phelanp/TSI-2018/Circuit_layout/TSI_BOM.xlsx

Reference | Value | DigiKey P/N | URL | Man P/N | Description | Price
U13 | PDQ10-D | 102-3865-ND | http://www.digikey.com/product-detail/en/cui-inc/PDQ10-Q24-S5-D/102-3865-ND/6165206 | PDQ10-Q24-S5-D | DC/DC CONVERTER 5V 10W | 25.82
U1 | PDM2-S24-S12 | 102-2728-ND | https://www.digikey.com/product-detail/en/cui-inc/PDM2-S24-S12-S/102-2728-ND/4009652 | PDM2-S24-S12-S | CONVERT DC/DC 2W 12V 167MA OUT | 5.71
SW1 | SW_PUSH | 1715-1676-1-ND | http://www.digikey.com/products/en?keywords=ckn9363ct-nd | 1.14100.5030000 | SWITCH PUSH SPST-NO 0.1A 42V | 2.4
SW2 | TS5A3159-Q1 | 296-39512-1-ND | http://www.digikey.com/product-detail/en/texas-instruments/TS5A3159QDBVRQ1/296-39512-1-ND/5143458 | TS5A3159QDBVRQ1 | IC ANLG SW SPDT SOT23-6 | 0.98
U4 | LM95071-Q1 | 296-40259-1-ND | https://www.digikey.com/products/en/sensors-transducers/temperature-sensors-analog-and-digital-output/518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 | LM95071QIMFX/NOPB | SENSOR TEMPERATURE SPI SOT23-5 | 2.9
U8 | 74ACT11030 | 296-4180-1-ND | http://www.digikey.com/product-detail/en/texas-instruments/74ACT11030DR/296-4180-1-ND/375133 | 74ACT11030DR | IC GATE NAND 1CH 8-INP 14-SOIC | 2.28
R44 | 120 | 311-120CRCT-ND | http://www.digikey.com/product-detail/en/yageo/RC0805FR-07120RL/311-120CRCT-ND/730522 | RC0805FR-07120RL | RES SMD 120 OHM 1% 1/8W 0805 | 0.1
R12 | 150 | 311-150CRCT-ND | http://www.digikey.com/product-detail/en/yageo/RC0805FR-07150RL/311-150CRCT-ND/730560 | RC0805FR-07150RL | RES SMD 150 OHM 1% 1/8W 0805 | 0.1
R15 | 150 | 311-150CRCT-ND | http://www.digikey.com/product-detail/en/yageo/RC0805FR-07150RL/311-150CRCT-ND/730560 | RC0805FR-07150RL | RES SMD 150 OHM 1% 1/8W 0805 | 0.1
R27 | 150 | 311-150CRCT-ND | http://www.digikey.com/product-detail/en/yageo/RC0805FR-07150RL/311-150CRCT-ND/730560 | RC0805FR-07150RL | RES SMD 150 OHM 1% 1/8W 0805 | 0.1
R70 | 47k | 311-47.0KCRCT-ND | http://www.digikey.com/product-detail/en/yageo/RC0805FR-0747KL/311-47.0KCRCT-ND/730920 | RC0805FR-0747KL | RES SMD 47K OHM 1% 1/8W 0805 | 0.1
C5 | 10p | 399-1108-1-ND | http://www.digikey.com/product-detail/en/kemet/C0805C100J5GACTU/399-1108-1-ND/411383 | C0805C100J5GACTU | CAP CER 10PF 50V NP0 0805 | 0.1
C6 | 10p | 399-1108-1-ND | http://www.digikey.com/product-detail/en/kemet/C0805C100J5GACTU/399-1108-1-ND/411383 | C0805C100J5GACTU | CAP CER 10PF 50V NP0 0805 | 0.1
C28 | 100p | 399-1122-1-ND | http://www.digikey.com/product-detail/en/kemet/C0805C101J5GACTU/399-1122-1-ND/411397 | C0805C101J5GACTU | CAP CER 100PF 50V NP0 0805 | 0.1
C29 | 100p | 399-1122-1-ND | http://www.digikey.com/product-detail/en/kemet/C0805C101J5GACTU/399-1122-1-ND/411397 | C0805C101J5GACTU | CAP CER 100PF 50V NP0 0805 | 0.1
C30 | 100p | 399-1122-1-ND | http://www.digikey.com/product-detail/en/kemet/C0805C101J5GACTU/399-1122-1-ND/411397 | C0805C101J5GACTU | CAP CER 100PF 50V NP0 0805 | 0.1
C41 | 100p | 399-1122-1-ND | http://www.digikey.com/product-detail/en/kemet/C0805C101J5GACTU/399-1122-1-ND/411397 | C0805C101J5GACTU | CAP CER 100PF 50V NP0 0805 | 0.1
C46 | 100p | 399-1122-1-ND | http://www.digikey.com/product-detail/en/kemet/C0805C101J5GACTU/399-1122-1-ND/411397 | C0805C101J5GACTU | CAP CER 100PF 50V NP0 0805 | 0.1
C47 | 100p | 399-1122-1-ND | http://www.digikey.com/product-detail/en/kemet/C0805C101J5GACTU/399-1122-1-ND/411397 | C0805C101J5GACTU | CAP CER 100PF 50V NP0 0805 | 0.1
C1 | 0.1u | 399-1168-1-ND | http://www.digikey.com/product-detail/en/kemet/C0805C104K3RACTU/399-1168-1-ND/411443 | C0805C104K3RACTU | CAP CER 0.1UF 25V X7R 0805 | 0.1
C12 | 0.1u | 399-1168-1-ND | http://www.digikey.com/product-detail/en/kemet/C0805C104K3RACTU/399-1168-1-ND/411443 | C0805C104K3RACTU | CAP CER 0.1UF 25V X7R 0805 | 0.1
C14 | 0.1u | 399-1168-1-ND | http://www.digikey.com/product-detail/en/kemet/C0805C104K3RACTU/399-1168-1-ND/411443 | C0805C104K3RACTU | CAP CER 0.1UF 25V X7R 0805 | 0.1
C15 | 0.1u | 399-1168-1-ND | http://www.digikey.com/product-detail/en/kemet/C0805C104K3RACTU/399-1168-1-ND/411443 | C0805C104K3RACTU | CAP CER 0.1UF 25V X7R 0805 | 0.1
C16 | 0.1u | 399-1168-1-ND | http://www.digikey.com/product-detail/en/kemet/C0805C104K3RACTU/399-1168-1-ND/411443 | C0805C104K3RACTU | CAP CER 0.1UF 25V X7R 0805 | 0.1
C17 | 0.1u | 399-1168-1-ND | http://www.digikey.com/product-detail/en/kemet/C0805C104K3RACTU/399-1168-1-ND/411443 | C0805C104K3RACTU | CAP CER 0.1UF 25V X7R 0805 | 0.1
C18 | 0.1u | 399-1168-1-ND | http://www.digikey.com/product-detail/en/kemet/C0805C104K3RACTU/399-1168-1-ND/411443 | C0805C104K3RACTU | CAP CER 0.1UF 25V X7R 0805 | 0.1
C2 | 0.1u | 399-1168-1-ND | http://www.digikey.com/product-detail/en/kemet/C0805C104K3RACTU/399-1168-1-ND/411443 | C0805C104K3RACTU | CAP CER 0.1UF 25V X7R 0805 | 0.1
C22 | 0.1u | 399-1168-1-ND | http://www.digikey.com/product-detail/en/kemet/C0805C104K3RACTU/399-1168-1-ND/411443 | C0805C104K3RACTU | CAP CER 0.1UF 25V X7R 0805 | 0.1
C23 | 0.1u | 399-1168-1-ND | http://www.digikey.com/product-detail/en/kemet/C0805C104K3RACTU/399-1168-1-ND/411443 | C0805C104K3RACTU | CAP CER 0.1UF 25V X7R 0805 | 0.1
C25 | 0.1u | 399-1168-1-ND | http://www.digikey.com/product-detail/en/kemet/C0805C104K3RACTU/399-1168-1-ND/411443 | C0805C104K3RACTU | CAP CER 0.1UF 25V X7R 0805 | 0.1
C26 | 0.1u | 399-1168-1-ND | http://www.digikey.com/product-detail/en/kemet/C0805C104K3RACTU/399-1168-1-ND/411443 | C0805C104K3RACTU | CAP CER 0.1UF 25V X7R 0805 | 0.1
C31 | 0.1u | 399-1168-1-ND | http://www.digikey.com/product-detail/en/kemet/C0805C104K3RACTU/399-1168-1-ND/411443 | C0805C104K3RACTU | CAP CER 0.1UF 25V X7R 0805 | 0.1
C32 | 0.1u | 399-1168-1-ND | http://www.digikey.com/product-detail/en/kemet/C0805C104K3RACTU/399-1168-1-ND/411443 | C0805C104K3RACTU | CAP CER 0.1UF 25V X7R 0805 | 0.1
C33 | 0.1u | 399-1168-1-ND | http://www.digikey.com/product-detail/en/kemet/C0805C104K3RACTU/399-1168-1-ND/411443 | C0805C104K3RACTU | CAP CER 0.1UF 25V X7R 0805 | 0.1
C34 | 0.1u | 399-1168-1-ND | http://www.digikey.com/product-detail/en/kemet/C0805C104K3RACTU/399-1168-1-ND/411443 | C0805C104K3RACTU | CAP CER 0.1UF 25V X7R 0805 | 0.1
C35 | 0.1u | 399-1168-1-ND | http://www.digikey.com/product-detail/en/kemet/C0805C104K3RACTU/399-1168-1-ND/411443 | C0805C104K3RACTU | CAP CER 0.1UF 25V X7R 0805 | 0.1
C37 | 0.1u | 399-1168-1-ND | http://www.digikey.com/product-detail/en/kemet/C0805C104K3RACTU/399-1168-1-ND/411443 | C0805C104K3RACTU | CAP CER 0.1UF 25V X7R 0805 | 0.1
C38 | 0.1u | 399-1168-1-ND | http://www.digikey.com/product-detail/en/kemet/C0805C104K3RACTU/399-1168-1-ND/411443 | C0805C104K3RACTU | CAP CER 0.1UF 25V X7R 0805 | 0.1
C40 | 0.1u | 399-1168-1-ND | http://www.digikey.com/product-detail/en/kemet/C0805C104K3RACTU/399-1168-1-ND/411443 | C0805C104K3RACTU | CAP CER 0.1UF 25V X7R 0805 | 0.1
C42 | 0.1u | 399-1168-1-ND | http://www.digikey.com/product-detail/en/kemet/C0805C104K3RACTU/399-1168-1-ND/411443 | C0805C104K3RACTU | CAP CER 0.1UF 25V X7R 0805 | 0.1
C43 | 0.1u | 399-1168-1-ND | http://www.digikey.com/product-detail/en/kemet/C0805C104K3RACTU/399-1168-1-ND/411443 | C0805C104K3RACTU | CAP CER 0.1UF 25V X7R 0805 | 0.1
C44 | 0.1u | 399-1168-1-ND | http://www.digikey.com/product-detail/en/kemet/C0805C104K3RACTU/399-1168-1-ND/411443 | C0805C104K3RACTU | CAP CER 0.1UF 25V X7R 0805 | 0.1
C45 | 0.1u | 399-1168-1-ND | http://www.digikey.com/product-detail/en/kemet/C0805C104K3RACTU/399-1168-1-ND/411443 | C0805C104K3RACTU | CAP CER 0.1UF 25V X7R 0805 | 0.1
C7 | 0.1u | 399-1168-1-ND | http://www.digikey.com/product-detail/en/kemet/C0805C104K3RACTU/399-1168-1-ND/411443 | C0805C104K3RACTU | CAP CER 0.1UF 25V X7R 0805 | 0.1
C8 | 0.1u | 399-1168-1-ND | http://www.digikey.com/product-detail/en/kemet/C0805C104K3RACTU/399-1168-1-ND/411443 | C0805C104K3RACTU | CAP CER 0.1UF 25V X7R 0805 | 0.1
SW3 | JS202011CQN | 401-2001-ND | http://www.digikey.com/product-detail/en/c-k/JS202011CQN/401-2001-ND/1640097 | JS202011CQN | SWITCH SLIDE DPDT 300MA 6V | 0.41
D3 | Spare/Fault | 475-1278-1-ND | http://www.digikey.com/product-detail/en/osram-opto-semiconductors-inc/LS-R976-NR-1/475-1278-1-ND/1642798 | LS R976-NR-1 | LED RED DIFFUSED 0805 SMD | 0.26
D1 | Power | 475-1410-1-ND | http://www.digikey.com/product-detail/en/osram-opto-semiconductors-inc/LG-R971-KN-1/475-1410-1-ND/1802598 | LG R971-KN-1 | LED GREEN DIFFUSED 0805 SMD | 0.25
D2 | Heartbeat | 475-2560-1-ND | http://www.digikey.com/product-detail/en/osram-opto-semiconductors-inc/LY-R976-PS-36/475-2560-1-ND/1802687 | LY R976-PS-36 | LED YELLOW DIFFUSED 0805 SMD | 0.35
C10 | 10uF | 490-10515-1-ND | http://www.digikey.com/product-detail/en/murata-electronics-north-america/GRM21BR6YA106ME43L/490-10515-1-ND/5026446 | GRM21BR6YA106ME43L | CAP CER 10UF 35V X5R 0805 | 0.36
C11 | 10uF | 490-10515-1-ND | http://www.digikey.com/product-detail/en/murata-electronics-north-america/GRM21BR6YA106ME43L/490-10515-1-ND/5026446 | GRM21BR6YA106ME43L | CAP CER 10UF 35V X5R 0805 | 0.36
C19 | 10uF | 490-10515-1-ND | http://www.digikey.com/product-detail/en/murata-electronics-north-america/GRM21BR6YA106ME43L/490-10515-1-ND/5026446 | GRM21BR6YA106ME43L | CAP CER 10UF 35V X5R 0805 | 0.36
C24 | 1uF | 490-3550-1-ND | http://www.digikey.com/product-detail/en/murata-electronics-north-america/GRM55DR72E105KW01L/490-3550-1-ND/789455 | GRM55DR72E105KW01L | CAP CER 1UF 250V X7R 2220 | 0.85
C4 | 47u | 490-6538-1-ND | http://www.digikey.com/product-detail/en/murata-electronics-north-america/GRM32ER61C476KE15K/490-6538-1-ND/3845735 | GRM32ER61C476KE15K | CAP CER 47UF 16V X5R 1210 | 0.86
U18 | TS912 | 497-10252-1-ND | http://www.digikey.com/product-detail/en/stmicroelectronics/TS912IYDT/497-10252-1-ND/2193329 | TS912IYDT | IC OPAMP GP 1.4MHZ RRO 8SO | 1.54
U6 | TS912 | 497-10252-1-ND | http://www.digikey.com/product-detail/en/stmicroelectronics/TS912IYDT/497-10252-1-ND/2193329 | TS912IYDT | IC OPAMP GP 1.4MHZ RRO 8SO | 1.54
U22 | TS372 | 497-2271-1-ND | http://www.digikey.com/product-detail/en/stmicroelectronics/TS372IDT/497-2271-1-ND/599224 | TS372IDT | IC COMP LP DUAL CMOS VOLT 8 SOIC | 0.62
D4 | Spare | 516-1445-1-ND | http://www.digikey.com/product-detail/en/broadcom-limited/HSMR-C170/516-1445-1-ND/637769 | HSMR-C170 | LED BLUE DIFFUSED 0805 SMD | 0.89
U19 | ACPL-C870 | 516-2578-5-ND | http://www.digikey.com/product-detail/en/broadcom-limited/ACPL-C870-000E/516-2578-5-ND/3523705 | ACPL-C870-000E | IC OPAMP ISOLATION 100KHZ 8SO | 5.39
U20 | ACPL-C870 | 516-2578-5-ND | http://www.digikey.com/product-detail/en/broadcom-limited/ACPL-C870-000E/516-2578-5-ND/3523705 | ACPL-C870-000E | IC OPAMP ISOLATION 100KHZ 8SO | 5.39
C3 | 2.2uF | 587-1293-1-ND | http://www.digikey.com/product-detail/en/taiyo-yuden/EMK212BJ225KG-T/587-1293-1-ND/931070 | EMK212BJ225KG-T | CAP CER 2.2UF 16V X5R 0805 | 0.16
L1 | 100uH | 587-2004-1-ND | https://www.digikey.com/product-detail/en/taiyo-yuden/NR8040T101M/587-2004-1-ND/1739117 | NR8040T101M | FIXED IND 100UH 1A 377 MOHM SMD | 0.6
CON1 | AVR-JTAG-10 | 609-4054-ND | http://www.digikey.com/product-detail/en/20021521-00010T1LF/609-4054-ND/2414951 | 20021521-00010T1LF | CONN HEADER 10POS DUAL SHRD SMD | 1.11
Y1 | 10MHz | 887-1741-1-ND | https://www.digikey.com/products/en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 | 7A-10.000MAAE-T | CRYSTAL 10.0000MHZ 12PF SMD | 0.66
P1 | TSV | A113980-ND | https://www.digikey.com/product-detail/en/te-connectivity-amp-connectors/556881-2/A113980-ND/294120 | 556881-2 | CONN RCPT 2POS 11.18MM PCB SLDR | 7.13
U7 | AT90CAN128-A | AT90CAN128-16AURCT-ND | https://www.digikey.com/product-detail/en/microchip-technology/AT90CAN128-16AUR/AT90CAN128-16AURCT-ND/3789383 | AT90CAN128-16AUR | IC MCU 8BIT 128KB FLASH 64TQFP | 7.66
U5 | LM7810CT | LM7810CT-ND | http://www.digikey.com/products/en?keywords=lm7810ct | LM7810CT | IC REG LDO 10V 1A TO220-3 | 0.64 | Changed to LM7810ACT
U16 | LTC3638 | LTC3638EMSE#PBF-ND | http://www.digikey.com/product-detail/en/linear-technology/LTC3638EMSE-PBF/LTC3638EMSE-PBF-ND/4693775 | LTC3638EMSE#PBF | IC REG BUCK ADJ 0.25A 16MSOP | 7.79
U10 | MCP2551-I/SN | MCP2551-I/SN-ND | http://www.digikey.com/product-detail/en/microchip-technology/MCP2551-I-SN/MCP2551-I-SN-ND/509452 | MCP2551-I/SN | IC TRANSCEIVER CAN HI-SPD 8-SOIC | 1.05
U21 | MCP6001 | MCP6001T-I/OTCT-ND | http://www.digikey.com/product-detail/en/microchip-technology/MCP6001T-I-OT/MCP6001T-I-OTCT-ND/697158 | MCP6001T-I/OT | IC OPAMP GP 1MHZ RRO SOT23-5 | 0.25
U2 | MCP6002 | MCP6002T-I/SNCT-ND | http://www.digikey.com/product-detail/en/microchip-technology/MCP6002T-I-SN/MCP6002T-I-SNCT-ND/4307905 | MCP6002T-I/SN | IC OPAMP GP 1MHZ RRO 8SOIC | 0.34
U17 | MCP6004 | MCP6004T-I/SLCT-ND | http://www.digikey.com/product-detail/en/microchip-technology/MCP6004T-I-SL/MCP6004T-I-SLCT-ND/5013527 | MCP6004T-I/SL | IC OPAMP GP RRO 1MHZ 14-SOIC | 0.45
U3 | MCP6004 | MCP6004T-I/SLCT-ND | http://www.digikey.com/product-detail/en/microchip-technology/MCP6004T-I-SL/MCP6004T-I-SLCT-ND/5013527 | MCP6004T-I/SL | IC OPAMP GP RRO 1MHZ 14-SOIC | 0.45
Q2 | MMBF170 | MMBF170CT-ND | http://www.digikey.com/product-detail/en/fairchild-on-semiconductor/MMBF170/MMBF170CT-ND/244295 | MMBF170 | MOSFET N-CH 60V 500MA SOT-23 | 0.35
Q3 | MMBF170 | MMBF170CT-ND | http://www.digikey.com/product-detail/en/fairchild-on-semiconductor/MMBF170/MMBF170CT-ND/244295 | MMBF170 | MOSFET N-CH 60V 500MA SOT-23 | 0.35
R37 | 1k | P1.00KCCT-ND | http://www.digikey.com/product-detail/en/panasonic-electronic-components/ERJ-6ENF1001V/P1.00KCCT-ND/118957 | ERJ-6ENF1001V | RES SMD 1K OHM 1% 1/8W 0805 | 0.1
R11 | 10k | P10.0KCCT-ND | http://www.digikey.com/product-detail/en/panasonic-electronic-components/ERJ-6ENF1002V/P10.0KCCT-ND/119248 | ERJ-6ENF1002V | RES SMD 10K OHM 1% 1/8W 0805 | 0.1
R13 | 10k | P10.0KCCT-ND | http://www.digikey.com/product-detail/en/panasonic-electronic-components/ERJ-6ENF1002V/P10.0KCCT-ND/119248 | ERJ-6ENF1002V | RES SMD 10K OHM 1% 1/8W 0805 | 0.1
R14 | 10k | P10.0KCCT-ND | http://www.digikey.com/product-detail/en/panasonic-electronic-components/ERJ-6ENF1002V/P10.0KCCT-ND/119248 | ERJ-6ENF1002V | RES SMD 10K OHM 1% 1/8W 0805 | 0.1
R17 | 10k | P10.0KCCT-ND | http://www.digikey.com/product-detail/en/panasonic-electronic-components/ERJ-6ENF1002V/P10.0KCCT-ND/119248 | ERJ-6ENF1002V | RES SMD 10K OHM 1% 1/8W 0805 | 0.1
R18 | 10k | P10.0KCCT-ND | http://www.digikey.com/product-detail/en/panasonic-electronic-components/ERJ-6ENF1002V/P10.0KCCT-ND/119248 | ERJ-6ENF1002V | RES SMD 10K OHM 1% 1/8W 0805 | 0.1
R21 | 10k | P10.0KCCT-ND | http://www.digikey.com/product-detail/en/panasonic-electronic-components/ERJ-6ENF1002V/P10.0KCCT-ND/119248 | ERJ-6ENF1002V | RES SMD 10K OHM 1% 1/8W 0805 | 0.1
R22 | 10k | P10.0KCCT-ND | http://www.digikey.com/product-detail/en/panasonic-electronic-components/ERJ-6ENF1002V/P10.0KCCT-ND/119248 | ERJ-6ENF1002V | RES SMD 10K OHM 1% 1/8W 0805 | 0.1
R23 | 10k | P10.0KCCT-ND | http://www.digikey.com/product-detail/en/panasonic-electronic-components/ERJ-6ENF1002V/P10.0KCCT-ND/119248 | ERJ-6ENF1002V | RES SMD 10K OHM 1% 1/8W 0805 | 0.1
R28 | 10k | P10.0KCCT-ND | http://www.digikey.com/product-detail/en/panasonic-electronic-components/ERJ-6ENF1002V/P10.0KCCT-ND/119248 | ERJ-6ENF1002V | RES SMD 10K OHM 1% 1/8W 0805 | 0.1
R29 | 10k | P10.0KCCT-ND | http://www.digikey.com/product-detail/en/panasonic-electronic-components/ERJ-6ENF1002V/P10.0KCCT-ND/119248 | ERJ-6ENF1002V | RES SMD 10K OHM 1% 1/8W 0805 | 0.1
R3 | 10k | P10.0KCCT-ND | http://www.digikey.com/product-detail/en/panasonic-electronic-components/ERJ-6ENF1002V/P10.0KCCT-ND/119248 | ERJ-6ENF1002V | RES SMD 10K OHM 1% 1/8W 0805 | 0.1
R31 | 10k | P10.0KCCT-ND | http://www.digikey.com/product-detail/en/panasonic-electronic-components/ERJ-6ENF1002V/P10.0KCCT-ND/119248 | ERJ-6ENF1002V | RES SMD 10K OHM 1% 1/8W 0805 | 0.1
R39 | 10k | P10.0KCCT-ND | http://www.digikey.com/product-detail/en/panasonic-electronic-components/ERJ-6ENF1002V/P10.0KCCT-ND/119248 | ERJ-6ENF1002V | RES SMD 10K OHM 1% 1/8W 0805 | 0.1
R4 | 10k | P10.0KCCT-ND | http://www.digikey.com/product-detail/en/panasonic-electronic-components/ERJ-6ENF1002V/P10.0KCCT-ND/119248 | ERJ-6ENF1002V | RES SMD 10K OHM 1% 1/8W 0805 | 0.1
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
R51 | 250k | P249KCCT-ND | http://www.digikey.com/product-detail/en/panasonic-electronic-components/ERJ-6ENF2493V/P249KCCT-ND/119664 | ERJ-6ENF2493V | RES SMD 249K OHM 1% 1/8W 0805 | 0.1
R52 | 250k | P249KCCT-ND | http://www.digikey.com/product-detail/en/panasonic-electronic-components/ERJ-6ENF2493V/P249KCCT-ND/119664 | ERJ-6ENF2493V | RES SMD 249K OHM 1% 1/8W 0805 | 0.1
R69 | 250k | P249KCCT-ND | http://www.digikey.com/product-detail/en/panasonic-electronic-components/ERJ-6ENF2493V/P249KCCT-ND/119664 | ERJ-6ENF2493V | RES SMD 249K OHM 1% 1/8W 0805 | 0.1
R71 | 330 | P330CCT-ND | http://www.digikey.com/product-detail/en/panasonic-electronic-components/ERJ-6ENF3300V/P330CCT-ND/1746851 | ERJ-6ENF3300V | RES SMD 330 OHM 1% 1/8W 0805 | 0.1
R72 | 330 | P330CCT-ND | http://www.digikey.com/product-detail/en/panasonic-electronic-components/ERJ-6ENF3300V/P330CCT-ND/1746851 | ERJ-6ENF3300V | RES SMD 330 OHM 1% 1/8W 0805 | 0.1
R73 | 330 | P330CCT-ND | http://www.digikey.com/product-detail/en/panasonic-electronic-components/ERJ-6ENF3300V/P330CCT-ND/1746851 | ERJ-6ENF3300V | RES SMD 330 OHM 1% 1/8W 0805 | 0.1
R74 | 330 | P330CCT-ND | http://www.digikey.com/product-detail/en/panasonic-electronic-components/ERJ-6ENF3300V/P330CCT-ND/1746851 | ERJ-6ENF3300V | RES SMD 330 OHM 1% 1/8W 0805 | 0.1
R32 | 4.75k | P4.75KCCT-ND | http://www.digikey.com/product-detail/en/panasonic-electronic-components/ERJ-6ENF4751V/P4.75KCCT-ND/119155 | ERJ-6ENF4751V | RES SMD 4.75K OHM 1% 1/8W 0805 | 0.1
R34 | 4.75k | P4.75KCCT-ND | http://www.digikey.com/product-detail/en/panasonic-electronic-components/ERJ-6ENF4751V/P4.75KCCT-ND/119155 | ERJ-6ENF4751V | RES SMD 4.75K OHM 1% 1/8W 0805 | 0.1
R33 | 499 | P499DACT-ND | http://www.digikey.com/product-detail/en/panasonic-electronic-components/ERA-6AEB4990V/P499DACT-ND/3075160 | ERA-6AEB4990V | RES SMD 499 OHM 0.1% 1/8W 0805 | 0.39
R79 | 499 | P499DACT-ND | http://www.digikey.com/product-detail/en/panasonic-electronic-components/ERA-6AEB4990V/P499DACT-ND/3075160 | ERA-6AEB4990V | RES SMD 499 OHM 0.1% 1/8W 0805 | 0.39
R81 | 499 | P499DACT-ND | http://www.digikey.com/product-detail/en/panasonic-electronic-components/ERA-6AEB4990V/P499DACT-ND/3075160 | ERA-6AEB4990V | RES SMD 499 OHM 0.1% 1/8W 0805 | 0.39
R82 | 499 | P499DACT-ND | http://www.digikey.com/product-detail/en/panasonic-electronic-components/ERA-6AEB4990V/P499DACT-ND/3075160 | ERA-6AEB4990V | RES SMD 499 OHM 0.1% 1/8W 0805 | 0.39
R83 | 499 | P499DACT-ND | http://www.digikey.com/product-detail/en/panasonic-electronic-components/ERA-6AEB4990V/P499DACT-ND/3075160 | ERA-6AEB4990V | RES SMD 499 OHM 0.1% 1/8W 0805 | 0.39
R1 | 665k | P665KCCT-ND | https://www.digikey.com/product-detail/en/panasonic-electronic-components/ERJ-6ENF6653V/P665KCCT-ND/20071 | ERJ-6ENF6653V | RES SMD 665K OHM 1% 1/8W 0805 | 0.1
R9 | 665k | P665KCCT-ND | https://www.digikey.com/product-detail/en/panasonic-electronic-components/ERJ-6ENF6653V/P665KCCT-ND/20071 | ERJ-6ENF6653V | RES SMD 665K OHM 1% 1/8W 0805 | 0.1
R76 | 750k | P750KCCT-ND | http://www.digikey.com/product-detail/en/panasonic-electronic-components/ERJ-6ENF7503V/P750KCCT-ND/119800 | ERJ-6ENF7503V | RES SMD 750K OHM 1% 1/8W 0805 | 0.1
R38 | 9.31k | P9.31KCCT-ND | http://www.digikey.com/product-detail/en/panasonic-electronic-components/ERJ-6ENF9311V/P9.31KCCT-ND/119238 | ERJ-6ENF9311V | RES SMD 9.31K OHM 1% 1/8W 0805 | 0.1
R80 | 9.31k | P9.31KCCT-ND | http://www.digikey.com/product-detail/en/panasonic-electronic-components/ERJ-6ENF9311V/P9.31KCCT-ND/119238 | ERJ-6ENF9311V | RES SMD 9.31K OHM 1% 1/8W 0805 | 0.1
D5 | D_Schottky | SK310A-LTPMSCT-ND | http://www.digikey.com/product-detail/en/SK310A-LTP/SK310A-LTPMSCT-ND/2642066 | SK310A-LTP | DIODE SCHOTTKY 100V 3A DO214AC | 0.6
U11 | TLP293 | TLP293(GB-TPLECT-ND | http://www.digikey.com/product-detail/en/toshiba-semiconductor-and-storage/TLP293(GB-TPL | TLP293(GB-TPL,E | OPTOISOLATOR 3.75KV TRANS 4-SO | 0.52
U12 | TLP293 | TLP293(GB-TPLECT-ND | http://www.digikey.com/product-detail/en/toshiba-semiconductor-and-storage/TLP293(GB-TPL | TLP293(GB-TPL,E | OPTOISOLATOR 3.75KV TRANS 4-SO | 0.52
U23 | TLP293 | TLP293(GB-TPLECT-ND | http://www.digikey.com/product-detail/en/toshiba-semiconductor-and-storage/TLP293(GB-TPL | TLP293(GB-TPL,E | OPTOISOLATOR 3.75KV TRANS 4-SO | 0.52
U24 | TLP293 | TLP293(GB-TPLECT-ND | http://www.digikey.com/product-detail/en/toshiba-semiconductor-and-storage/TLP293(GB-TPL | TLP293(GB-TPL,E | OPTOISOLATOR 3.75KV TRANS 4-SO | 0.52
U27 | TLP293 | TLP293(GB-TPLECT-ND | http://www.digikey.com/product-detail/en/toshiba-semiconductor-and-storage/TLP293(GB-TPL | TLP293(GB-TPL,E | OPTOISOLATOR 3.75KV TRANS 4-SO | 0.52
U9 | TLP293 | TLP293(GB-TPLECT-ND | http://www.digikey.com/product-detail/en/toshiba-semiconductor-and-storage/TLP293(GB-TPL | TLP293(GB-TPL,E | OPTOISOLATOR 3.75KV TRANS 4-SO | 0.52
P2 | CONN_02X10 | WM14741-ND | https://www.digikey.com/product-detail/en/molex-llc/0906631201/WM14741-ND/3469224 | 906631201 | QF50 SRD HDR VT .1AU 20POS | 2.31
J5 | RJ12 | WM3789CT-ND | http://www.digikey.com/product-search/en?keywords=WM3789CT-ND | 855135002 | CONN MOD JACK 6P6C VERT UNSHLD | 1.16
J1 | Spare_Conns | WM4128-ND | https://www.digikey.com/product-detail/en/molex-llc/0705430112/WM4128-ND/1643361 | 705430112 | CONN HEADER 8POS .100 VERT 30AU | 1.88
J4 | Motor_Ctrl | WM4802-ND | https://www.digikey.com/product-detail/en/molex-llc/0705430003/WM4802-ND/114923 | 705430003 | CONN HEADER 4POS .100 VERT GOLD | 0.94
P3 | CONN_02X07 | WM8632-ND | https://www.digikey.com/product-detail/en/molex-connector-corporation/0905711141/WM8632-ND/3044753 | 905711141 | CONN HEADER 14POS 2.54MM VERT | 2.4
JP1 | JUMPER3 | Z5375-ND | http://www.digikey.com/product-detail/en/omron-electronics-inc-emc-div/XG8V-0331/Z5375-ND/4947407 | XG8V-0331 | JUMPER PLUG 3POS SING ROW | 0.26
Q1 | ZVP4525G | ZVP4525GCT-ND | http://www.digikey.com/product-detail/en/diodes-incorporated/ZVP4525GTA/ZVP4525GCT-ND/386036 | ZVP4525GTA | MOSFET P-CH 250V 0.265A SOT223 | 0.68
 |  |  |  |  | Total: | 114.51
