phelanp/TSI-2018/website/tsi_box_wiring_diagram_1_1.pdf

W12

HV+

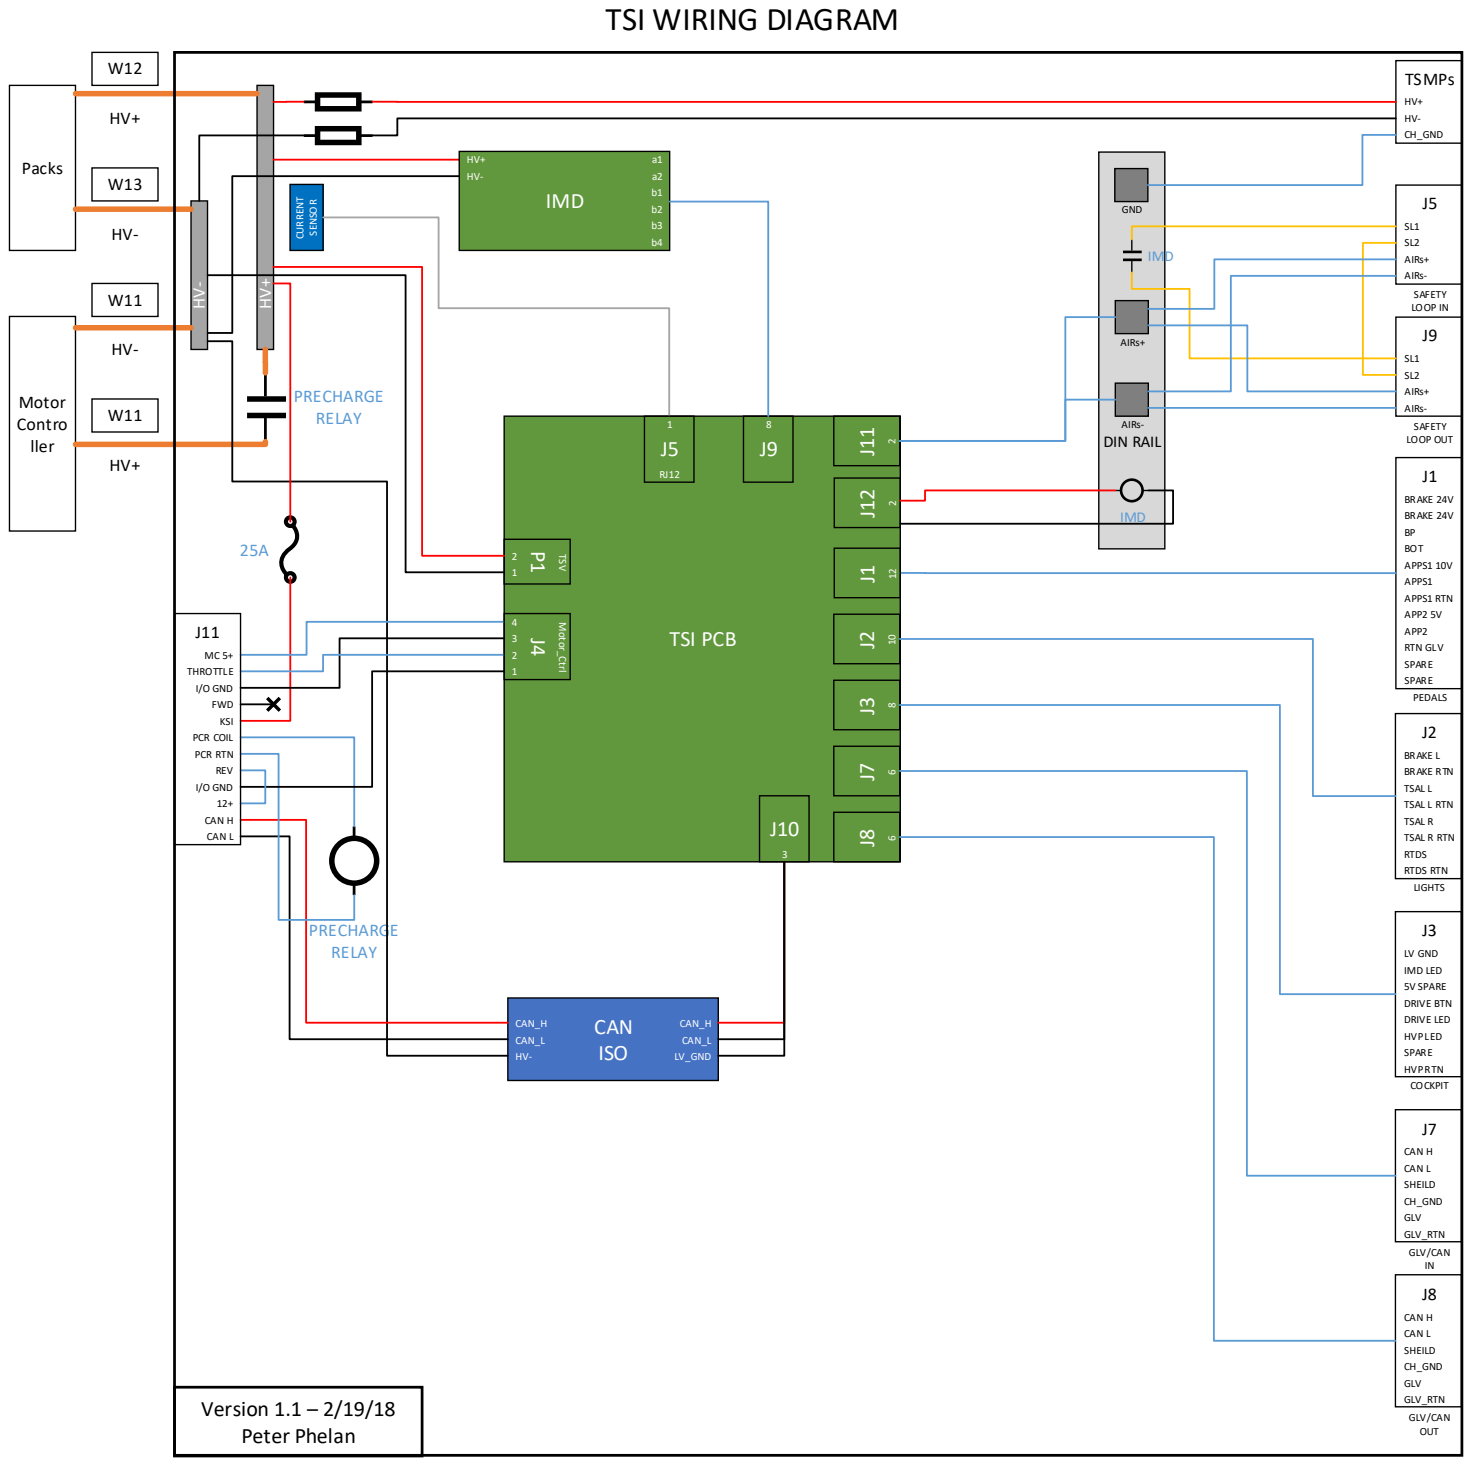
[picture p1: page 1]
