phelanp/TSI-2018/website/box_wiring_diagram.pdf

W12

HV+

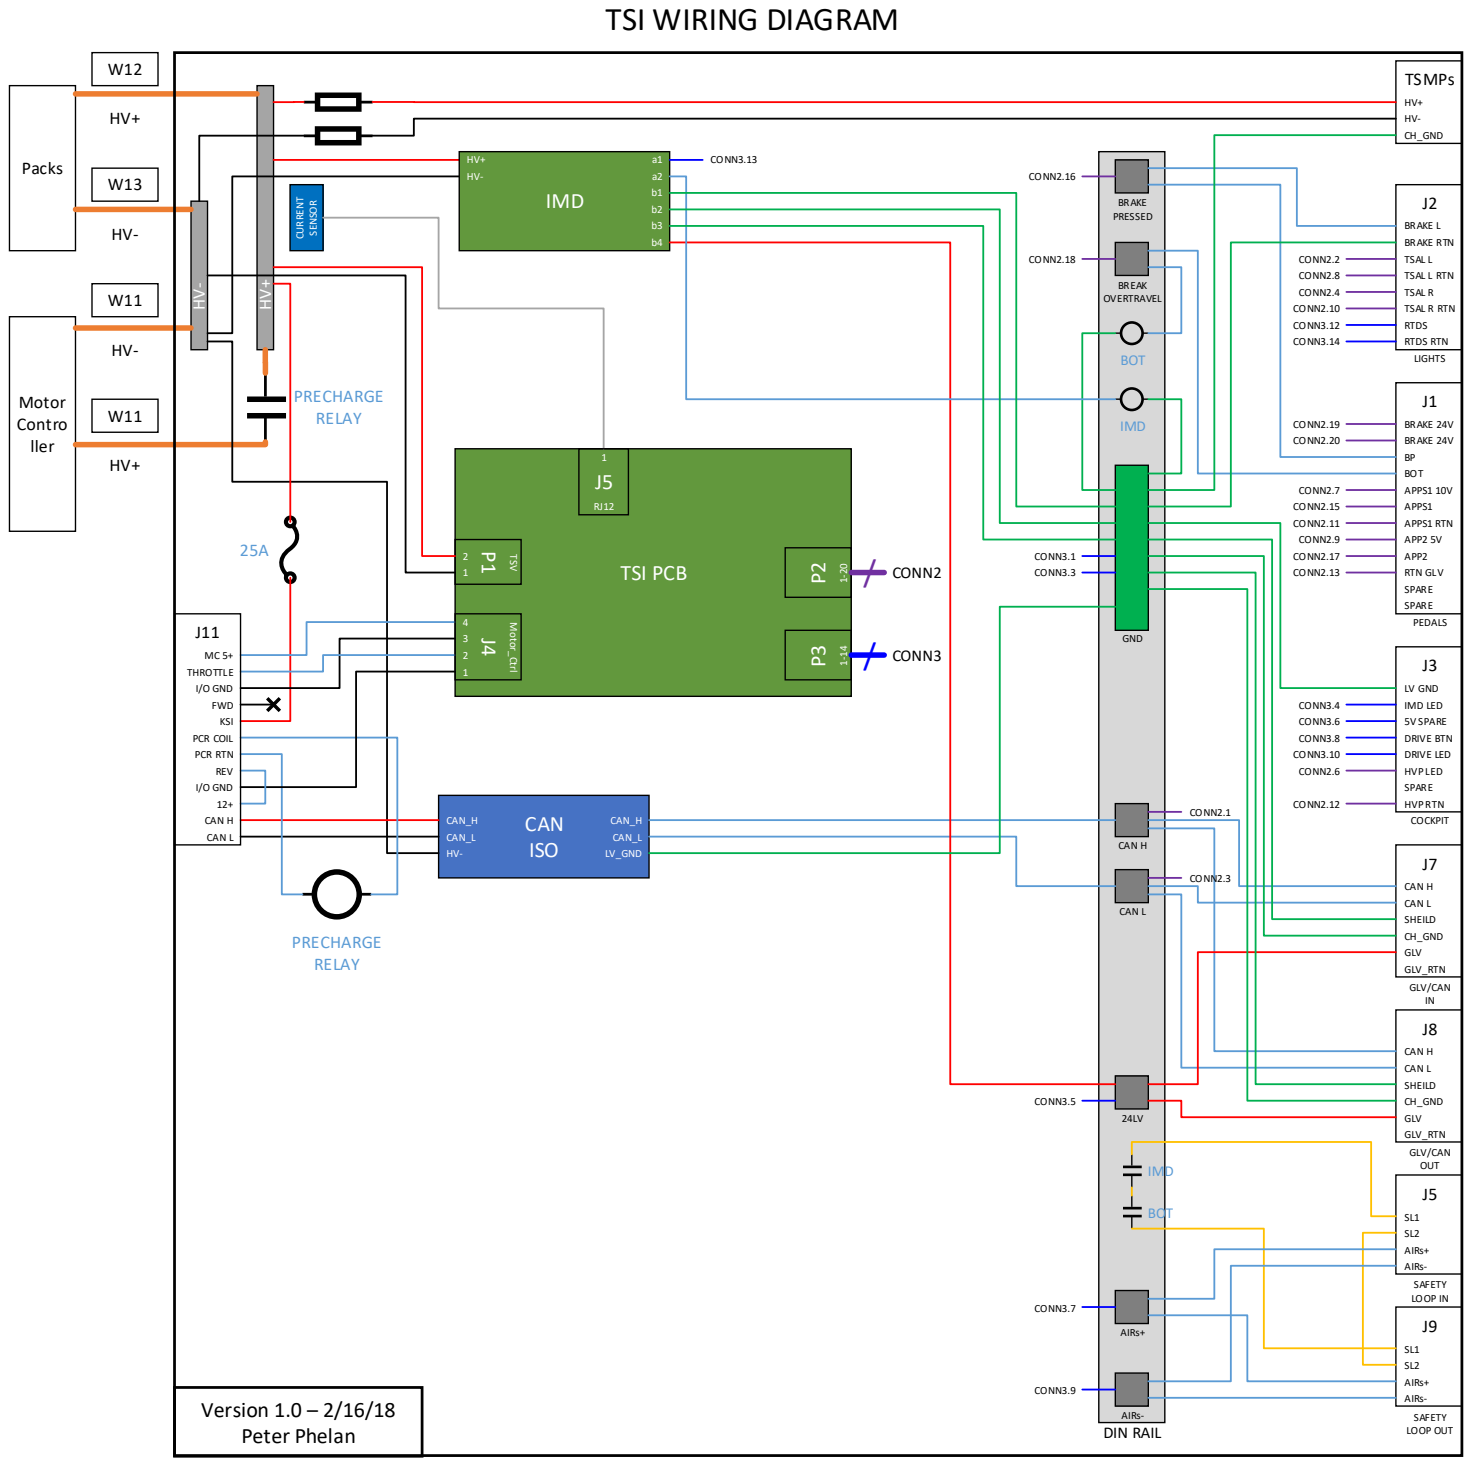
[picture p2: page 1]
