phelanp/TSI-2018/website/tsi_circuit_layout_pcb.pdf

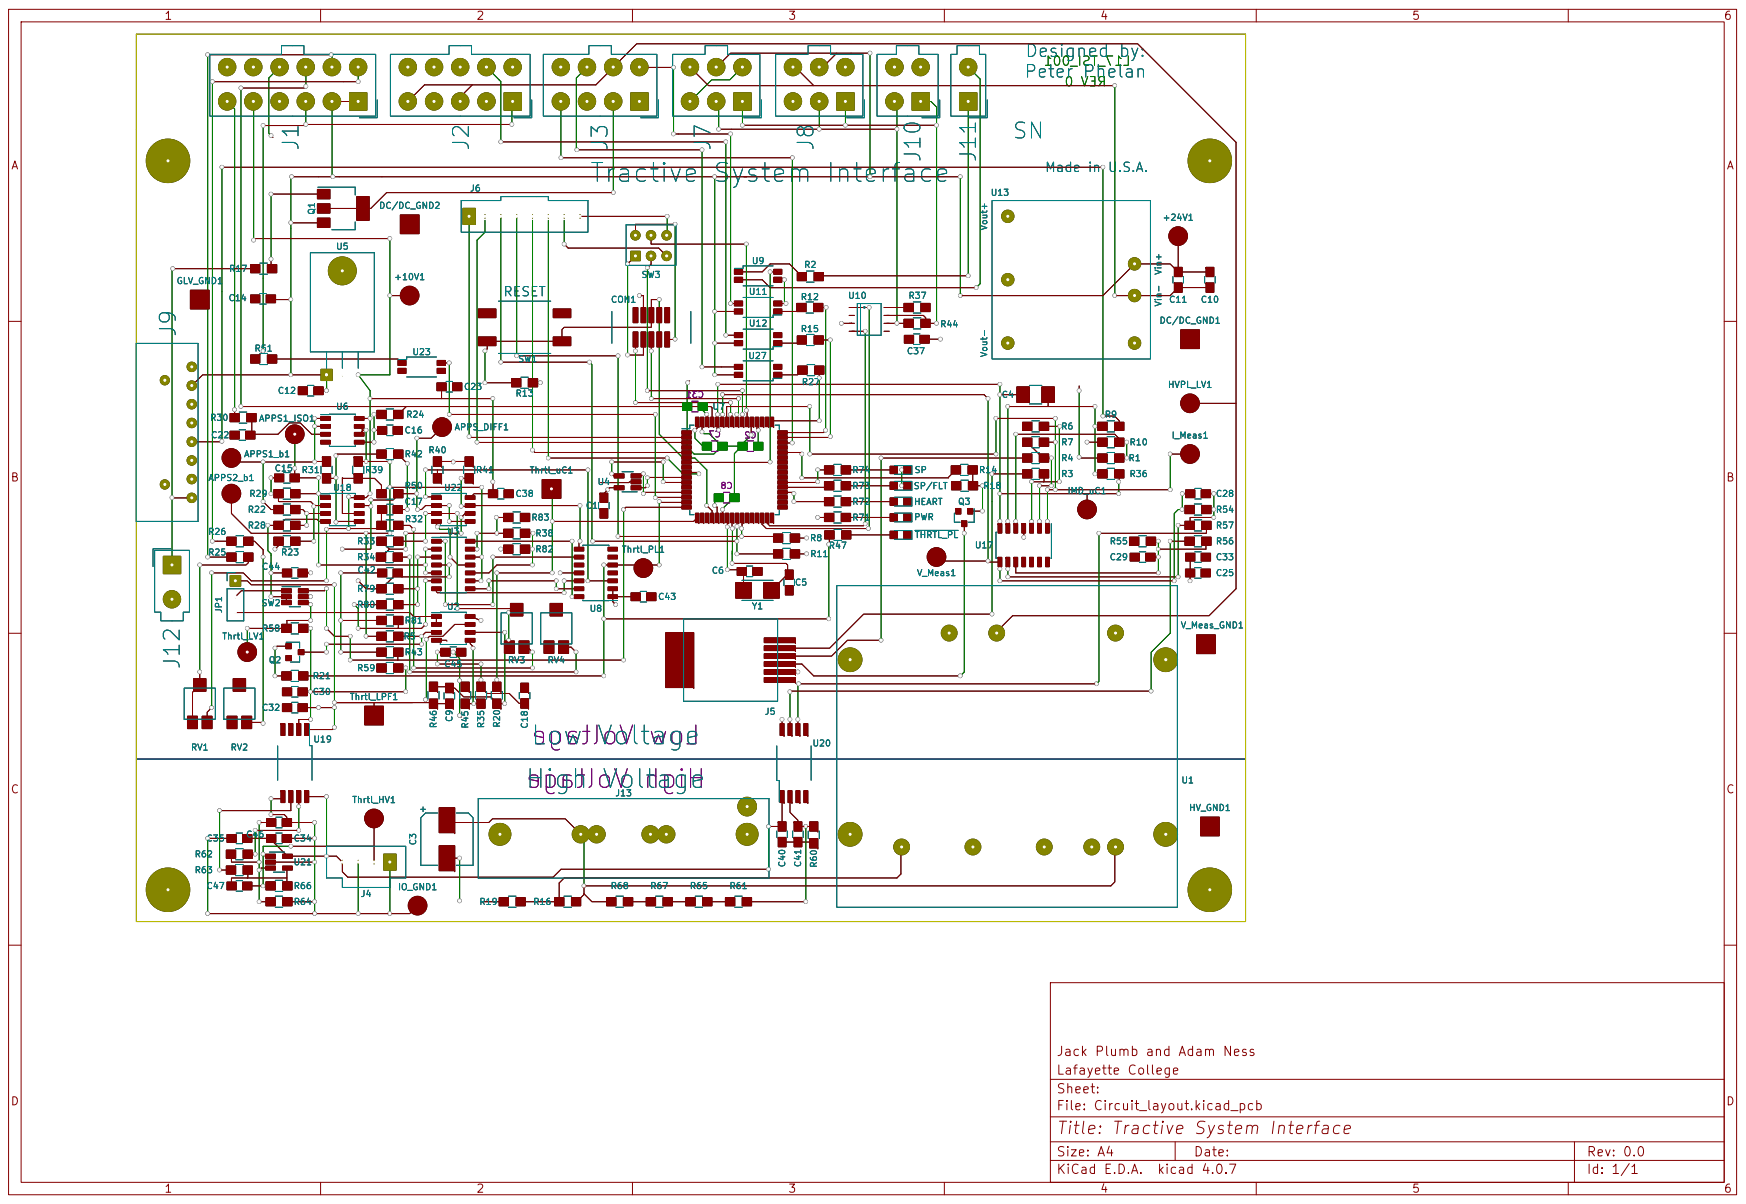
[picture p10: page 1]
