phelanp/TSI-2018/Circuit_layout/Circuit_layout.kicad_pcb

## KiCad design Circuit_layout/Circuit_layout.kicad_pcb (2018-02-27)

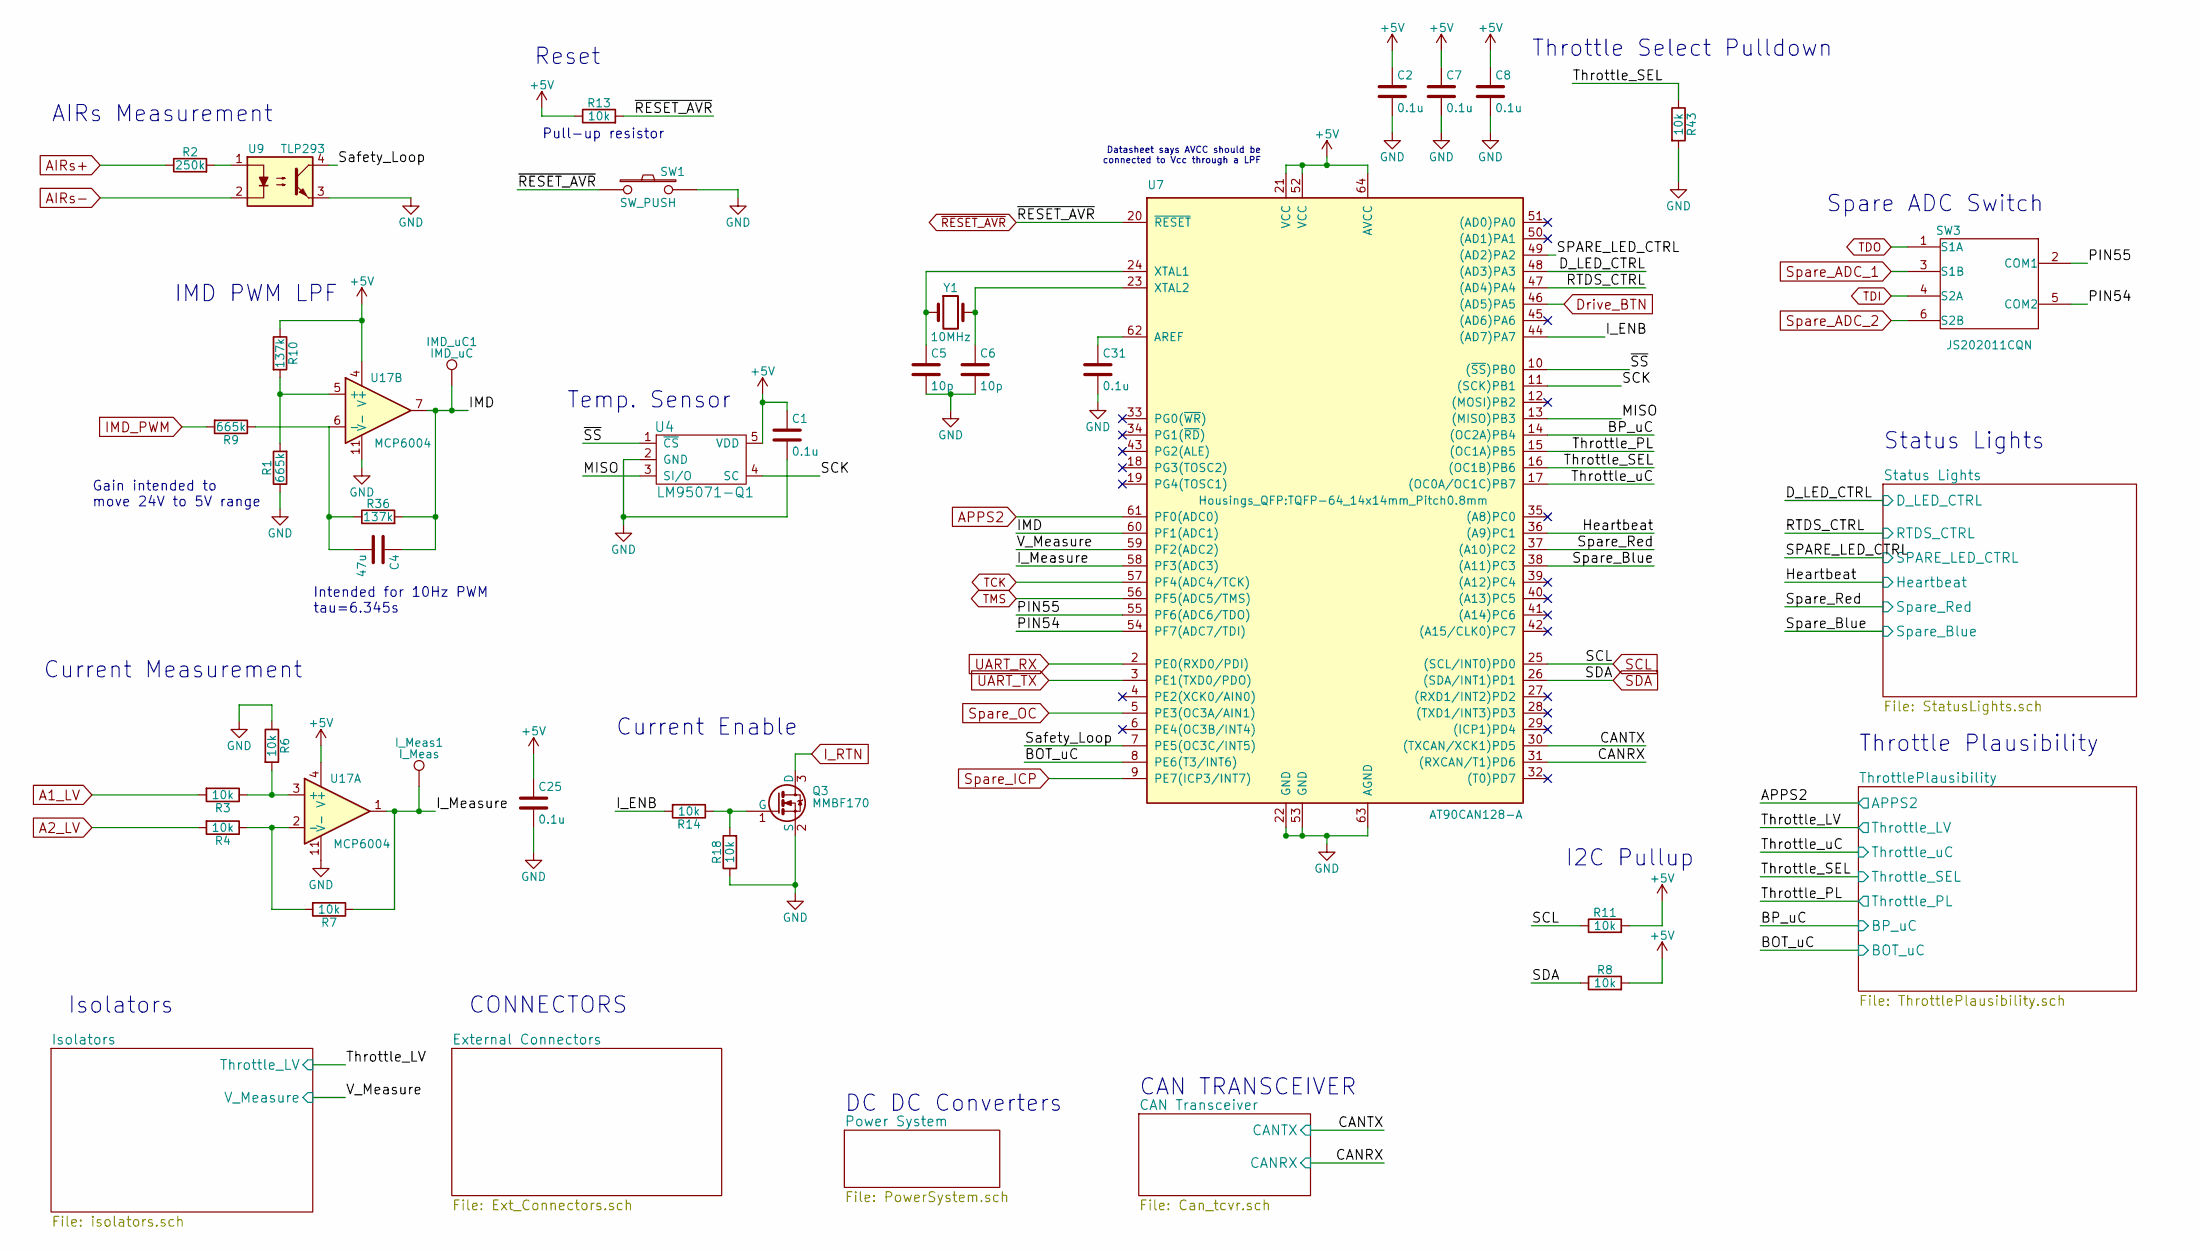
[picture p11: schematic Circuit_layout.sch, Tractive System Interface]

Parts:
C1, C2, C7, C8, C25, C31: 0.1u; C_0805_HandSoldering; Digikey P/N 399-1168-1-ND
C4: 47u; C_1210_HandSoldering; Digikey P/N 490-6538-1-ND
C5, C6: 10p; C_0805_HandSoldering; DigiKey P/N 399-1108-1-ND
IMD_uC1: IMD_uC; Measurement_Point_Round-SMD-Pad_Big
I_Meas1: I_Meas; Measurement_Point_Round-SMD-Pad_Big
Q3: MMBF170; SOT-23; Digikey P/N MMBF170CT-ND
R1, R9: 665k; R_0805_HandSoldering; DigiKey P/N P665KCCT-ND
R2: 250k; R_0805_HandSoldering; DigiKey P/N P249KCCT-ND
R3, R4, R6, R7, R8, R11, R13, R14, R18, R43: 10k; R_0805_HandSoldering; DigiKey P/N P10.0KCCT-ND
R10, R36: 137k; R_0805_HandSoldering; DigiKey P/N P137KCCT-ND
SW1: SW_PUSH; SW_RACON_8; DigiKey P/N 1715-1676-1-ND
SW3: JS202011CQN; CK_DPDT_Switch; DigiKey P/N 401-2001-ND
U4: LM95071-Q1; SOT-23-5_HandSoldering; DigiKey P/N 296-40259-1-ND
U7: AT90CAN128-A; TQFP-64_14x14mm_Pitch0.8mm; DigiKey P/N AT90CAN128-16AURCT-ND
U9: TLP293; SOP-4_4.4x2.8mm_Pitch1.27mm; DigiKey P/N TLP293(GB-TPLECT-ND
U17: MCP6004; SOIC-14_3.9x8.7mm_Pitch1.27mm; Digikey P/N MCP6004T-I/SLCT-ND
Y1: 10MHz; crystal_TXC_7A; DigiKey P/N 887-1741-1-ND

Connections:
+5V: C1.1, C2.1, C7.1, C8.1, C25.1, R8.2, R10.1, R11.2, R13.1, U4.5 (VDD), U7.21 (VCC), U7.52 (VCC), U7.64 (AVCC), U17.4 (V+); also elsewhere on the board
/BP_uC: U7.14 ((OC2A)PB4); also elsewhere on the board
/CANRX: U7.31 ((RXCAN/T1)PD6); also elsewhere on the board
/CANTX: U7.30 ((TXCAN/XCK1)PD5); also elsewhere on the board
/D_LED_CTRL: U7.48 ((AD3)PA3); also elsewhere on the board
/Heartbeat: U7.36 ((A9)PC1); also elsewhere on the board
/IMD: C4.1, IMD_uC1.1, R36.2, U7.60 (PF1(ADC1)), U17.7
/I_ENB: R14.2, U7.44 ((AD7)PA7)
/I_Measure: I_Meas1.1, R7.1, U7.58 (PF3(ADC3)), U17.1
/MISO: U4.3 (SI/O), U7.13 ((MISO)PB3)
/PIN54: SW3.5 (COM2), U7.54 (PF7(ADC7/TDI))
/PIN55: SW3.2 (COM1), U7.55 (PF6(ADC6/TDO))
/RTDS_CTRL: U7.47 ((AD4)PA4); also elsewhere on the board
/SCK: U4.4 (SC), U7.11 ((SCK)PB1)
/SPARE_LED_CTRL: U7.49 ((AD2)PA2); also elsewhere on the board
/Safety_Loop: U7.7 (PE5(OC3C/INT5)), U9.4
/Spare_Blue: U7.38 ((A11)PC3); also elsewhere on the board
/Spare_Red: U7.37 ((A10)PC2); also elsewhere on the board
/Throttle_PL: U7.15 ((OC1A)PB5); also elsewhere on the board
/Throttle_SEL: R43.1, U7.16 ((OC1B)PB6); also elsewhere on the board
/Throttle_uC: U7.17 ((OC0A/OC1C)PB7); also elsewhere on the board
/V_Measure: U7.59 (PF2(ADC2)); also elsewhere on the board
/~SS: U4.1 (~CS), U7.10 ((~SS~)PB0)
A1_LV: R3.2; also elsewhere on the board
A2_LV: R4.2; also elsewhere on the board
AIRs+: R2.1; also elsewhere on the board
AIRs-: U9.2; also elsewhere on the board
APPS2: U7.61 (PF0(ADC0)); also elsewhere on the board
CH_GND: C1.2, C2.2, C5.2, C6.2, C7.2, C8.2, C25.2, C31.2, Q3.2 (S), R1.1, R6.1, R18.1, R43.2, SW1.2, U4.2 (GND), U7.22 (GND), U7.53 (GND), U7.63 (AGND), U9.3, U17.11 (V-); also elsewhere on the board
Drive_BTN: U7.46 ((AD5)PA5); also elsewhere on the board
IMD_PWM: R9.2; also elsewhere on the board
I_RTN: Q3.3 (D); also elsewhere on the board
unnamed: C4.2, R9.1, R36.1, U17.6 (-)
unnamed: C5.1, U7.24 (XTAL1), Y1.1
unnamed: C6.1, U7.23 (XTAL2), Y1.2
unnamed: C31.1, U7.62 (AREF)
unnamed: Q3.1 (G), R14.1, R18.2
unnamed: R1.2, R10.2, U17.5 (+)
unnamed: R2.2, U9.1
unnamed: R3.1, R6.2, U17.3 (+)
unnamed: R4.1, R7.2, U17.2 (-)
SCL: R11.1, U7.25 ((SCL/INT0)PD0); also elsewhere on the board
SDA: R8.1, U7.26 ((SDA/INT1)PD1); also elsewhere on the board
Spare_ADC_1: SW3.3 (S1B); also elsewhere on the board
Spare_ADC_2: SW3.6 (S2B); also elsewhere on the board
Spare_ICP: U7.9 (PE7(ICP3/INT7)); also elsewhere on the board
Spare_OC: U7.5 (PE3(OC3A/AIN1)); also elsewhere on the board
TCK: U7.57 (PF4(ADC4/TCK)); also elsewhere on the board
TDI: SW3.4 (S2A); also elsewhere on the board
TDO: SW3.1 (S1A); also elsewhere on the board
TMS: U7.56 (PF5(ADC5/TMS)); also elsewhere on the board
UART_RX: U7.2 (PE0(RXD0/PDI)); also elsewhere on the board
UART_TX: U7.3 (PE1(TXD0/PDO)); also elsewhere on the board
~RESET_AVR: R13.2, SW1.1, U7.20 (~RESET); also elsewhere on the board

Notes on the sheet:
CONNECTORS
CAN TRANSCEIVER
Current Measurement
IMD PWM LPF
AIRs Measurement
Throttle Plausibility
Status Lights
DC DC Converters
Isolators
Intended for 10Hz PWM tau=6.345s
I2C Pullup
Datasheet says AVCC should be connected to Vcc through a LPF
Pull-up resistor
Reset
Throttle Select Pulldown
Spare ADC Switch
Current Enable
Gain intended to move 24V to 5V range
Temp. Sensor

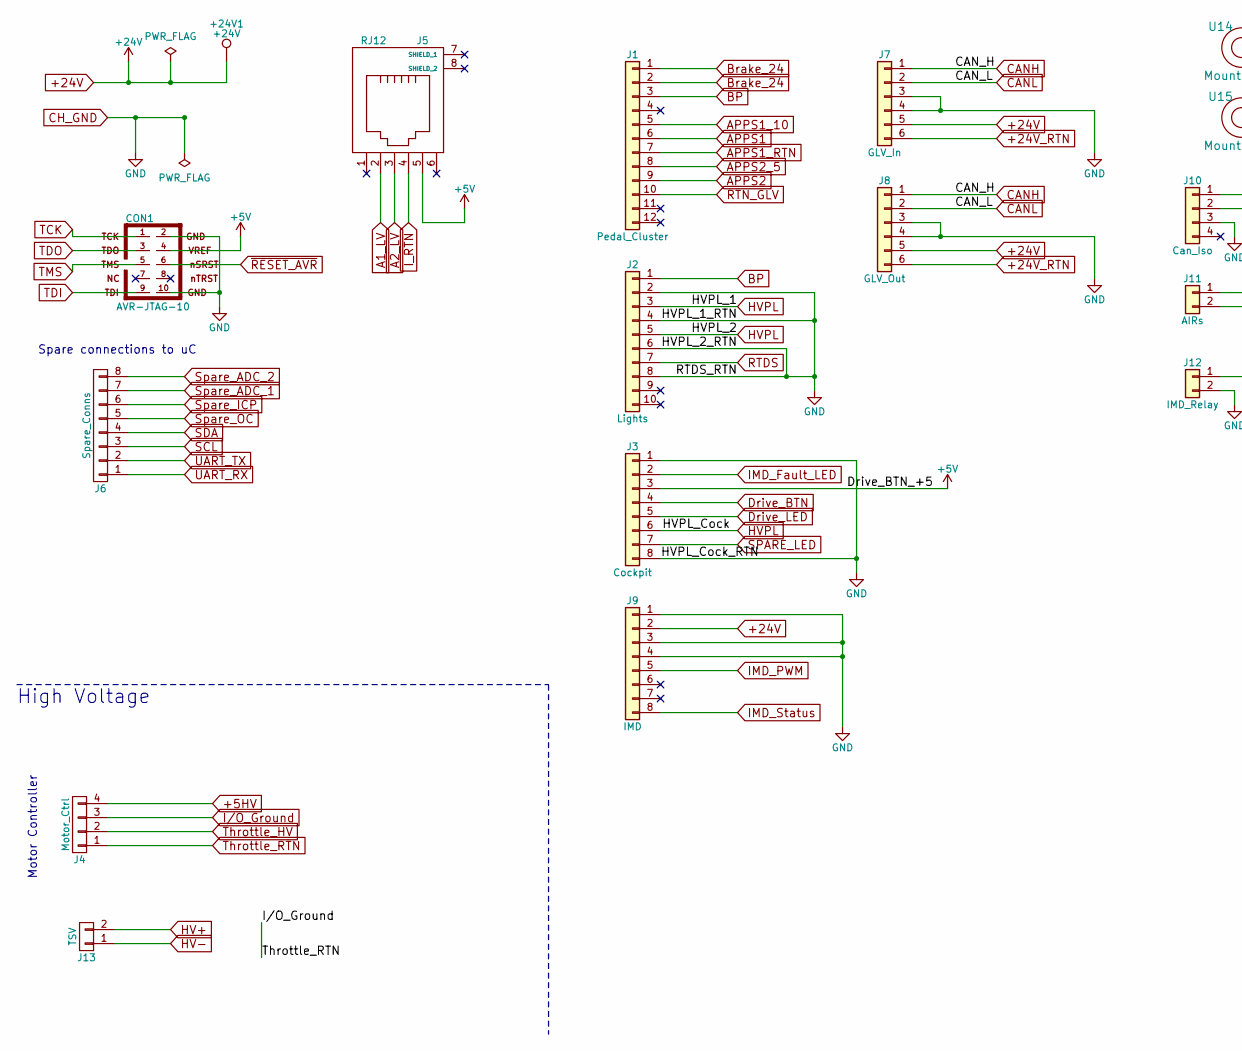
[picture p12: schematic Ext_Connectors.sch, Tractive System Interface, part in row 1, column 1]

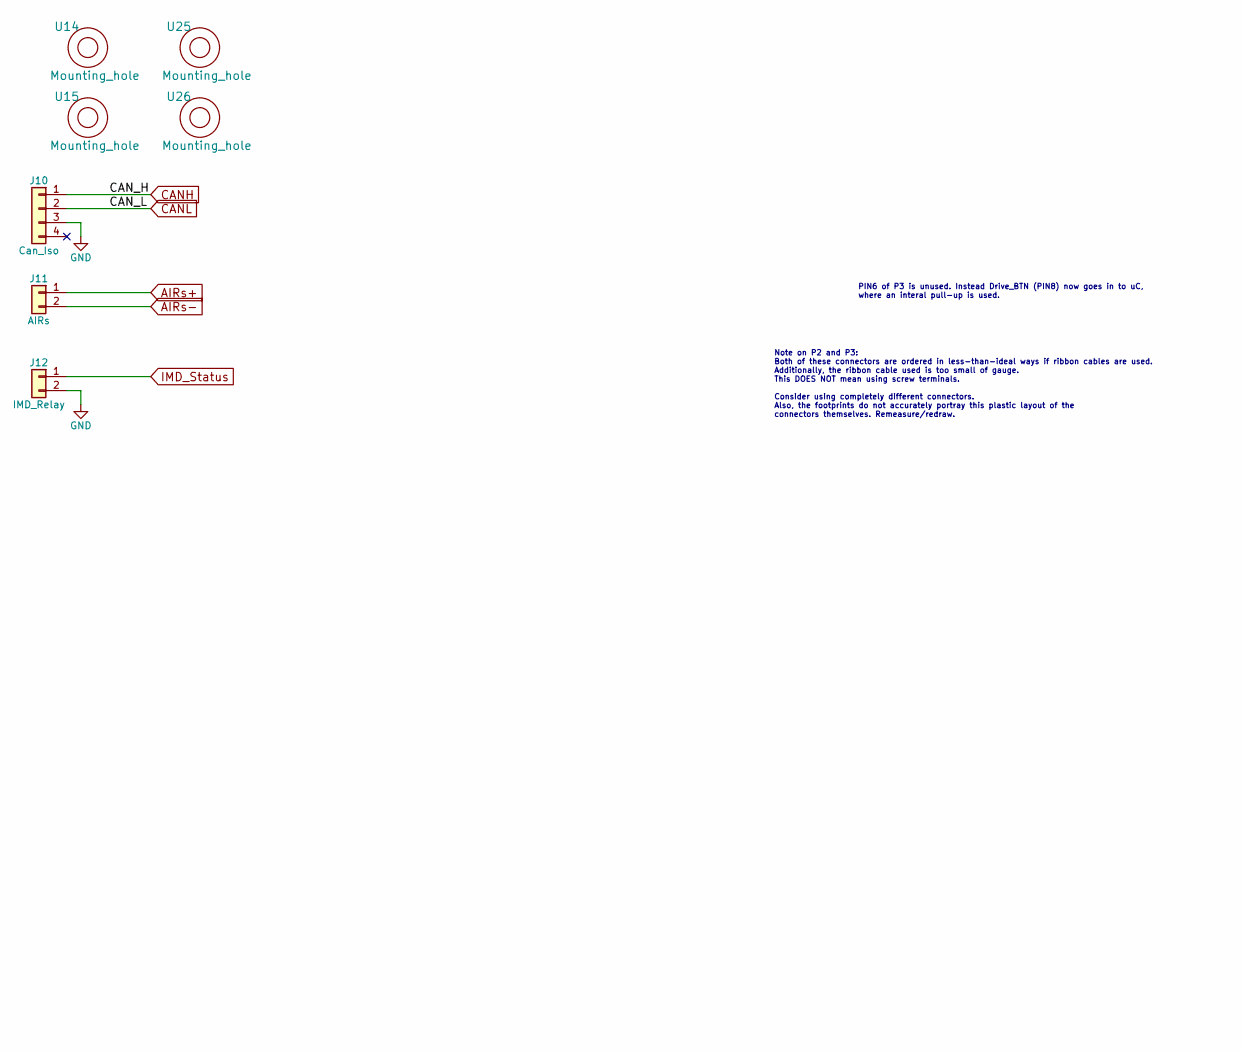
[picture p13: schematic Ext_Connectors.sch, Tractive System Interface, part in row 1, column 2]

Parts:
+24V1: +24V; Measurement_Point_Round-SMD-Pad_Big
CON1: AVR-JTAG-10; JTAG; DigiKey P/N 609-4054-ND
J1: Pedal_Cluster; Molex_MiniFit-JR-5556-12A_2x06x4.20mm_Straight
J2: Lights; Molex_MiniFit-JR-5556-10A_2x05x4.20mm_Straight
J3: Cockpit; Molex_MiniFit-JR-5556-08A_2x04x4.20mm_Straight
J4: Motor_Ctrl; Molex_4x1_2.54mm; DigiKey P/N WM4802-ND
J5: RJ12; MOLEX_RJ11; DigiKey P/N WM3789CT-ND
J6: Spare_Conns; Molex_8x1_2.54mm; DigiKey P/N WM4128-ND
J7: GLV_In; Molex_MiniFit-JR-5556-06A_2x03x4.20mm_Straight
J8: GLV_Out; Molex_MiniFit-JR-5556-06A_2x03x4.20mm_Straight
J9: IMD; IMD_Header
J10: Can_Iso; Molex_MiniFit-JR-5556-04A_2x02x4.20mm_Straight
J11: AIRs; Molex_MiniFit-JR-5556-02A_2x01x4.20mm_Straight
J12: IMD_Relay; Molex_MiniFit-JR-5556-02A_2x01x4.20mm_Straight
J13: TSV; AMPCONN_2; DigiKey P/N A113980-ND
U14, U15, U25, U26: Mounting_hole; MountingHole_3.5mm_Pad

Connections:
+5HV: J4.4; also elsewhere on the board
+5V: CON1.4, J3.3, J5.5; also elsewhere on the board
+24V: +24V1.1, J1.1, J1.2, J7.5, J8.5, J9.2; also elsewhere on the board
+24V_RTN: J7.6, J8.6; also elsewhere on the board
A1_LV: J5.2; also elsewhere on the board
A2_LV: J5.3; also elsewhere on the board
AIRs+: J11.1; also elsewhere on the board
AIRs-: J11.2; also elsewhere on the board
APPS1: J1.6; also elsewhere on the board
APPS1_10: J1.5; also elsewhere on the board
APPS1_RTN: J1.7; also elsewhere on the board
APPS2: J1.9; also elsewhere on the board
APPS2_5: J1.8; also elsewhere on the board
BP: J1.3, J2.1; also elsewhere on the board
CANH: J7.1, J8.1, J10.1; also elsewhere on the board
CANL: J7.2, J8.2, J10.2; also elsewhere on the board
CH_GND: CON1.2, CON1.10, J1.10, J2.2, J2.4, J2.6, J2.8, J3.1, J3.8, J7.3, J7.4, J8.3, J8.4, J9.1, J9.3, J9.4, J10.3, J12.2; also elsewhere on the board
Drive_BTN: J3.4; also elsewhere on the board
Drive_LED: J3.5; also elsewhere on the board
HV+: J13.2; also elsewhere on the board
HV-: J13.1; also elsewhere on the board
HVPL: J2.3, J2.5, J3.6; also elsewhere on the board
I/O_Ground: J4.1, J4.3; also elsewhere on the board
IMD_Fault_LED: J3.2; also elsewhere on the board
IMD_PWM: J9.5; also elsewhere on the board
IMD_Status: J9.8, J12.1; also elsewhere on the board
I_RTN: J5.4; also elsewhere on the board
RTDS: J2.7; also elsewhere on the board
SCL: J6.3; also elsewhere on the board
SDA: J6.4; also elsewhere on the board
SPARE_LED: J3.7; also elsewhere on the board
Spare_ADC_1: J6.7; also elsewhere on the board
Spare_ADC_2: J6.8; also elsewhere on the board
Spare_ICP: J6.6; also elsewhere on the board
Spare_OC: J6.5; also elsewhere on the board
TCK: CON1.1; also elsewhere on the board
TDI: CON1.9; also elsewhere on the board
TDO: CON1.3; also elsewhere on the board
TMS: CON1.5; also elsewhere on the board
Throttle_HV: J4.2; also elsewhere on the board
UART_RX: J6.1; also elsewhere on the board
UART_TX: J6.2; also elsewhere on the board
~RESET_AVR: CON1.6; also elsewhere on the board

Notes on the sheet:
Motor Controller
High Voltage
Spare connections to uC
PIN6 of P3 is unused. Instead Drive_BTN (PIN8) now goes in to uC, where an interal pull-up is used.
Note on P2 and P3: Both of these connectors are ordered in less-than-ideal ways if ribbon cables are used. Additionally, the ribbon cable used is too small of gauge. This DOES NOT mean using screw terminals. Consider using completely different connectors. Also, the footprints do not accurately port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

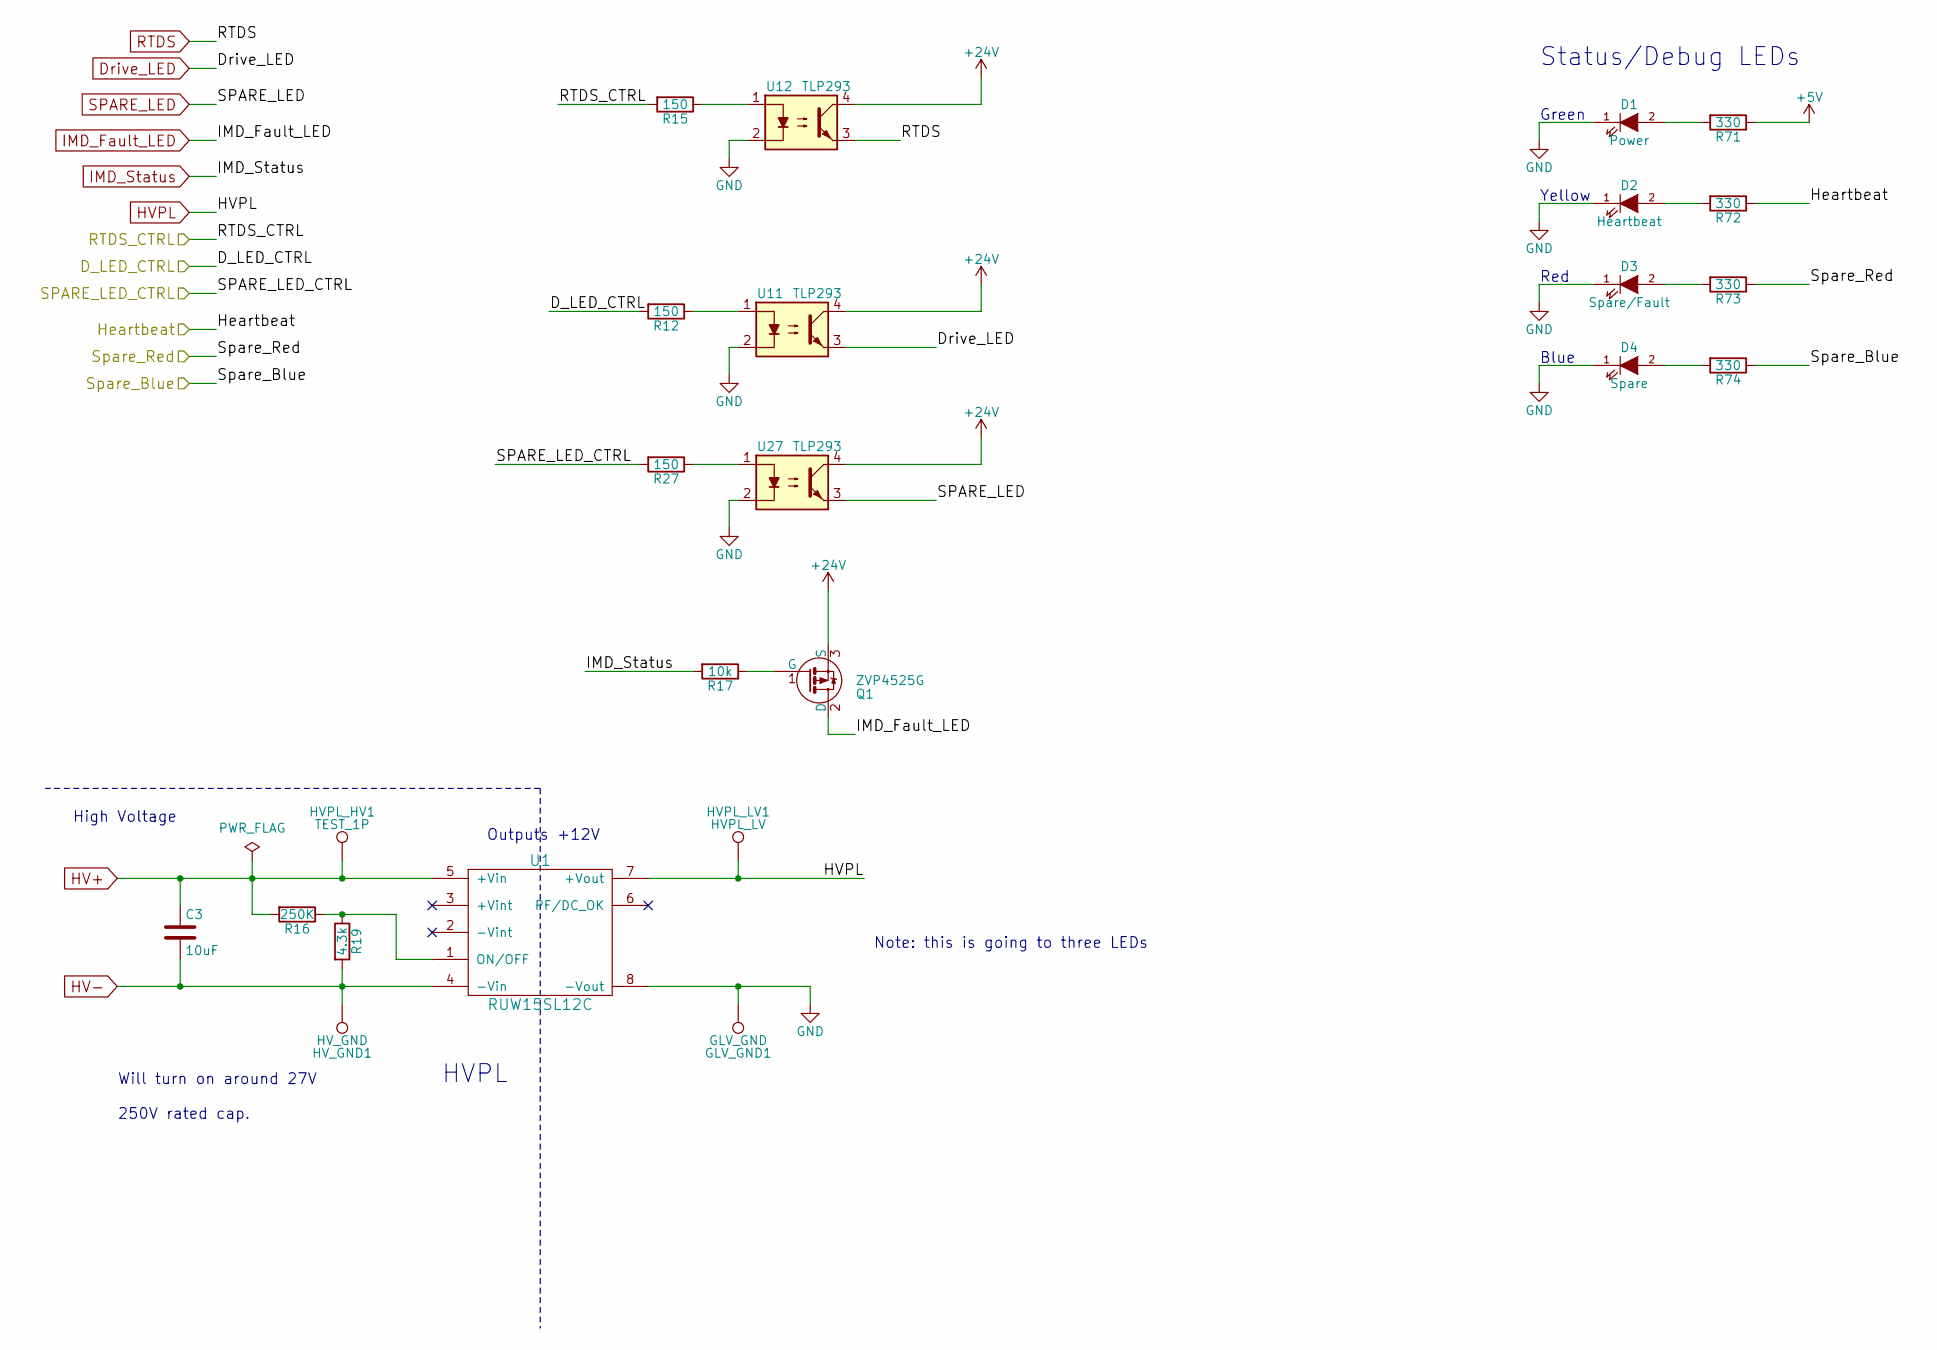
[picture p14: schematic StatusLights.sch, Tractive System Interface]

Parts:
C3: 10uF; CP_Radial_D10.0mm_P5.00mm; DigiKey P/N 490-3550-1-ND
D1: Power; LED_0805; DigiKey P/N 475-1410-1-ND
D2: Heartbeat; LED_0805; DigiKey P/N 475-2560-1-ND
D3: Spare/Fault; LED_0805; DigiKey P/N 475-1278-1-ND
D4: Spare; LED_0805; DigiKey P/N 516-1445-1-ND
GLV_GND1: GLV_GND; Measurement_Point_Square-SMD-Pad_Big
HVPL_HV1: TEST_1P; Measurement_Point_Round-SMD-Pad_Big
HVPL_LV1: HVPL_LV; Measurement_Point_Round-SMD-Pad_Big
HV_GND1: HV_GND; Measurement_Point_Square-SMD-Pad_Big
Q1: ZVP4525G; SOT-223-3Lead_TabPin2; DigiKey P/N ZVP4525GCT-ND
R12, R15, R27: 150; R_0805_HandSoldering; DigiKey P/N 311-150CRCT-ND
R16: 250K; R_0805_HandSoldering
R17: 10k; R_0805_HandSoldering; DigiKey P/N P10.0KCCT-ND
R19: 4.3k; R_0805_HandSoldering
R71, R72, R73, R74: 330; R_0805_HandSoldering; DigiKey P/N P330CCT-ND
U1: RUW15SL12C; RUW15
U11, U12, U27: TLP293; SOP-4_4.4x2.8mm_Pitch1.27mm; DigiKey P/N TLP293(GB-TPLECT-ND

Connections:
+5V: R71.1; also elsewhere on the board
+24V: Q1.3 (S), U11.4, U12.4, U27.4; also elsewhere on the board
/D_LED_CTRL: R12.2; also elsewhere on the board
/Heartbeat: R72.1; also elsewhere on the board
/RTDS_CTRL: R15.2; also elsewhere on the board
/SPARE_LED_CTRL: R27.2; also elsewhere on the board
/Spare_Blue: R74.1; also elsewhere on the board
/Spare_Red: R73.1; also elsewhere on the board
CH_GND: D1.1 (K), D2.1 (K), D3.1 (K), D4.1 (K), GLV_GND1.1, U1.8 (-Vout), U11.2, U12.2, U27.2; also elsewhere on the board
Drive_LED: U11.3; also elsewhere on the board
HV+: C3.1, HVPL_HV1.1, R16.2, U1.5 (+Vin); also elsewhere on the board
HV-: C3.2, HV_GND1.1, R19.2, U1.4 (-Vin); also elsewhere on the board
HVPL: HVPL_LV1.1, U1.7 (+Vout); also elsewhere on the board
IMD_Fault_LED: Q1.2 (D); also elsewhere on the board
IMD_Status: R17.2; also elsewhere on the board
unnamed: D1.2 (A), R71.2
unnamed: D2.2 (A), R72.2
unnamed: D3.2 (A), R73.2
unnamed: D4.2 (A), R74.2
unnamed: Q1.1 (G), R17.1
unnamed: R12.1, U11.1
unnamed: R15.1, U12.1
unnamed: R16.1, R19.1, U1.1 (ON/OFF)
unnamed: R27.1, U27.1
RTDS: U12.3; also elsewhere on the board
SPARE_LED: U27.3; also elsewhere on the board

Notes on the sheet:
Green
Yellow
Red
Blue
Status/Debug LEDs
High Voltage
Note: this is going to three LEDs
Outputs +12V
HVPL
Will turn on around 27V 250V rated cap.

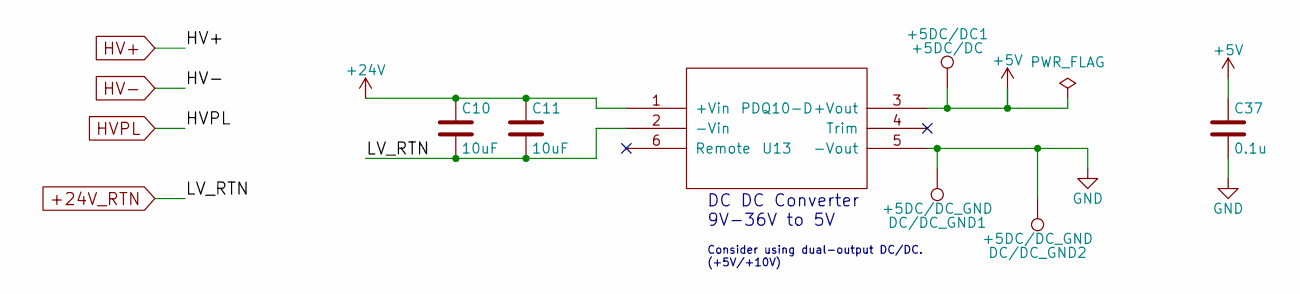
[picture p15: schematic PowerSystem.sch, Tractive System Interface]

Parts:
+5DC/DC1: +5DC/DC; trim_pot
C10, C11: 10uF; C_0805_HandSoldering; DigiKey P/N 490-10515-1-ND
C37: 0.1u; C_0805_HandSoldering; Digikey P/N 399-1168-1-ND
DC/DC_GND1, DC/DC_GND2: +5DC/DC_GND; Measurement_Point_Square-SMD-Pad_Big
U13: PDQ10-D; PDQ_DCDC; DigiKey P/N 102-3865-ND

Connections:
+5V: +5DC/DC1.1, C37.1, U13.3 (+Vout); also elsewhere on the board
+24V: C10.1, C11.1, U13.1 (+Vin); also elsewhere on the board
+24V_RTN: C10.2, C11.2, U13.2 (-Vin); also elsewhere on the board
CH_GND: C37.2, DC/DC_GND1.1, DC/DC_GND2.1, U13.5 (-Vout); also elsewhere on the board

Notes on the sheet:
DC DC Converter 9V-36V to 5V
Consider using dual-output DC/DC. (+5V/+10V)

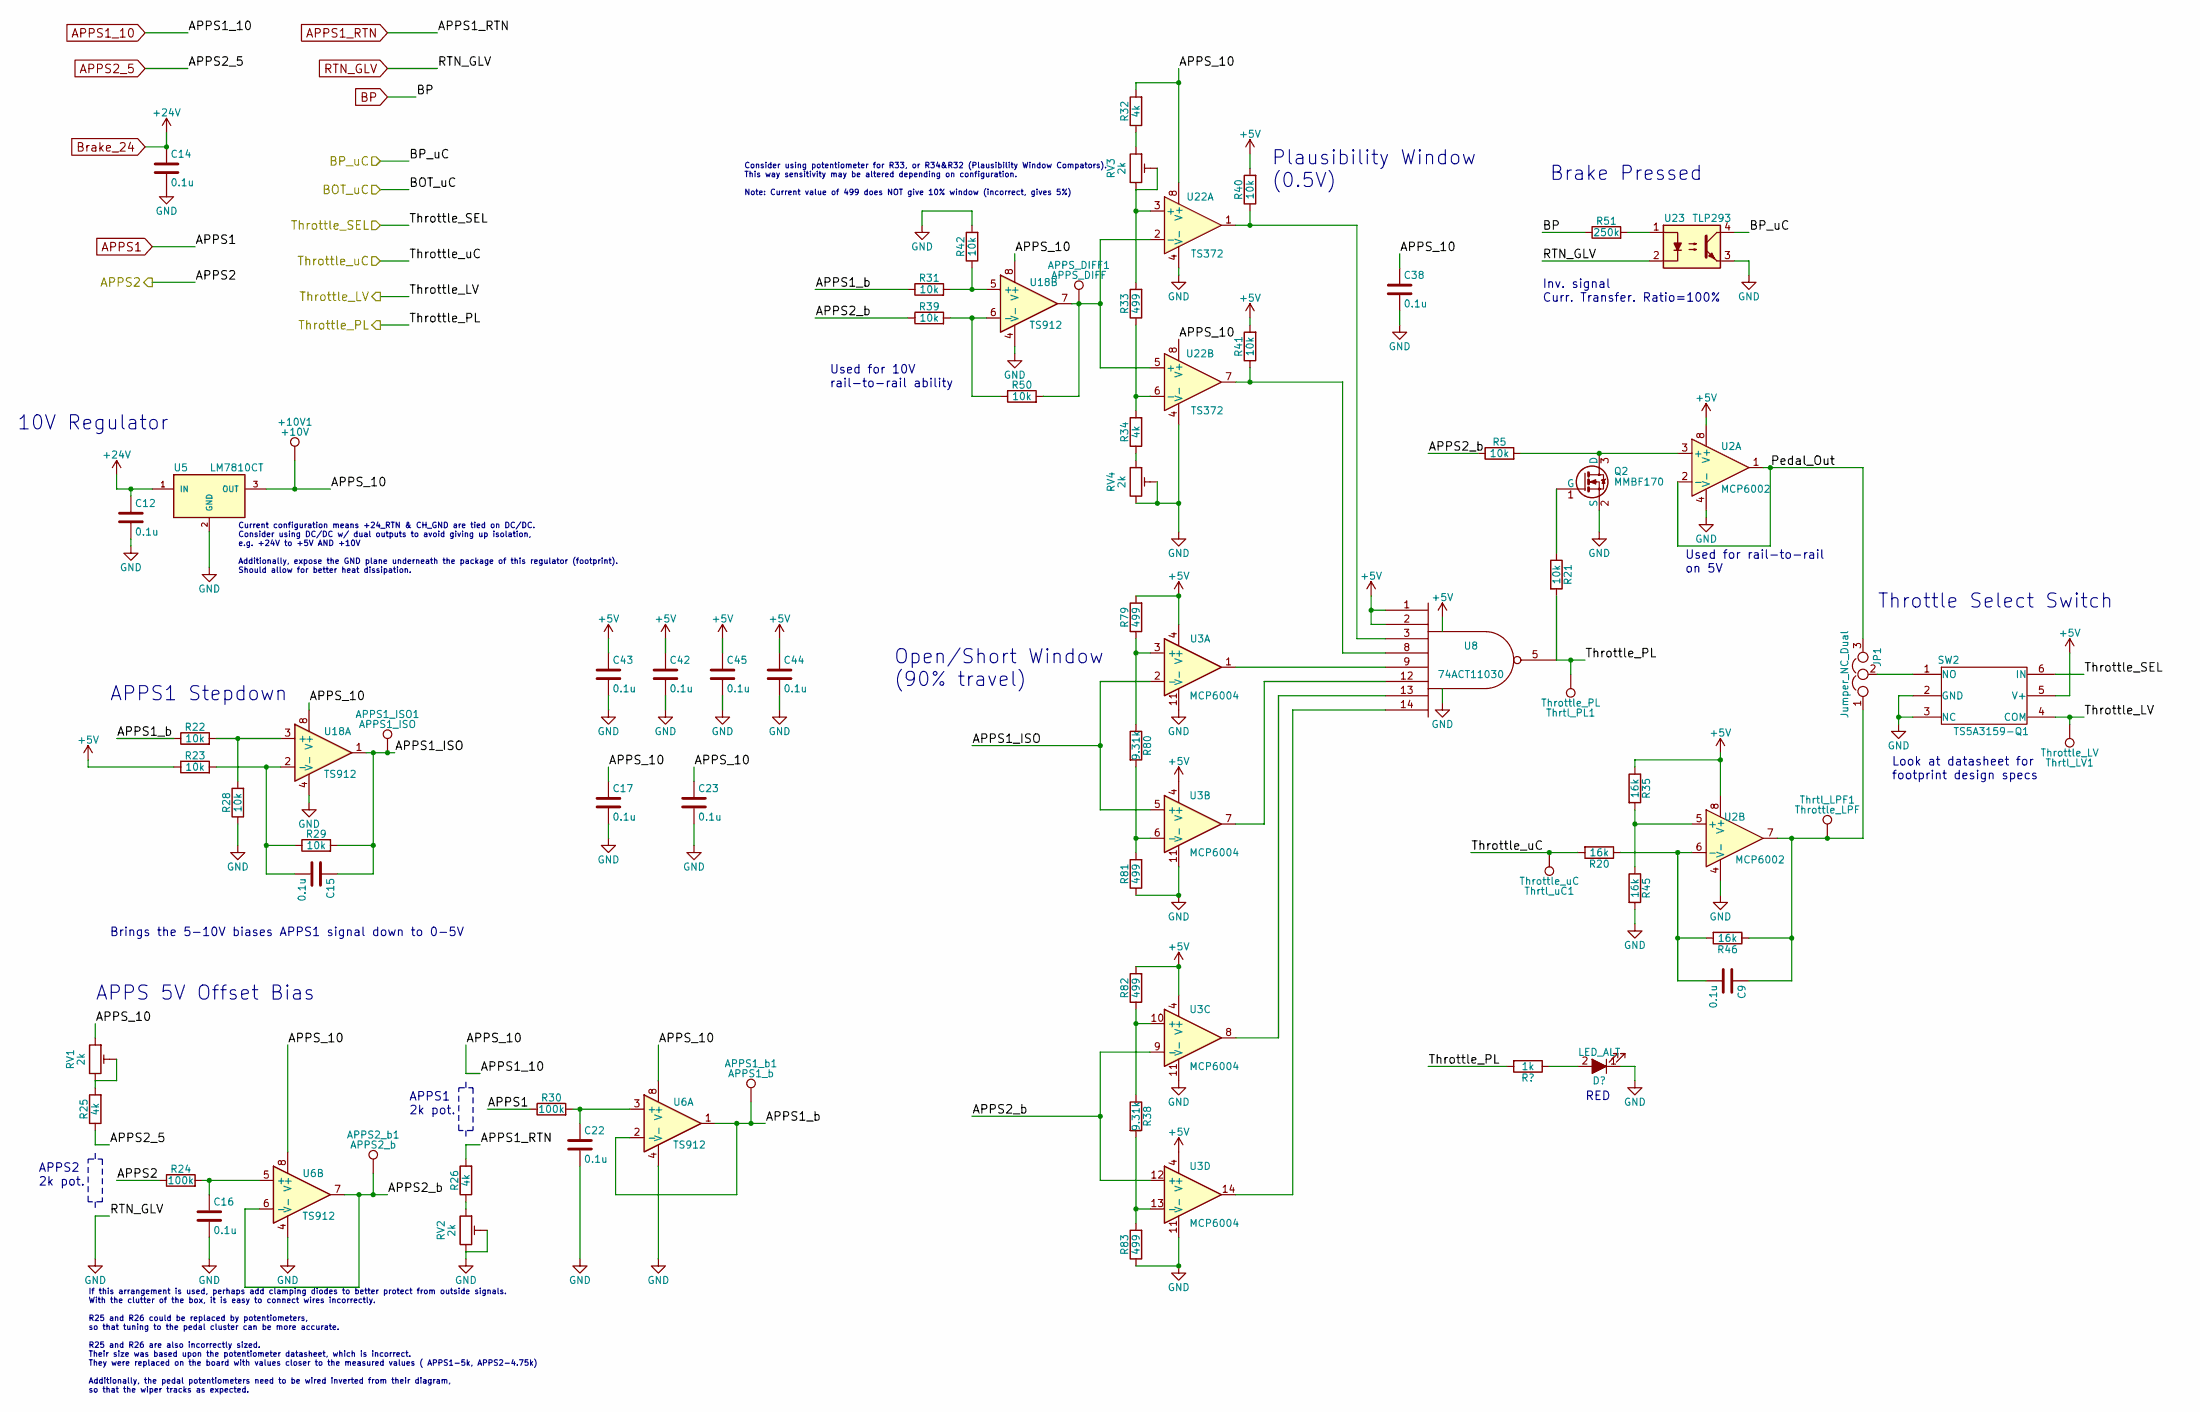
[picture p16: schematic ThrottlePlausibility.sch, Tractive System Interface]

Parts:
+10V1: +10V; Measurement_Point_Round-SMD-Pad_Big
APPS1_ISO1: APPS1_ISO; Measurement_Point_Round-SMD-Pad_Big
APPS1_b1: APPS1_b; Measurement_Point_Round-SMD-Pad_Big
APPS2_b1: APPS2_b; Measurement_Point_Round-SMD-Pad_Big
APPS_DIFF1: APPS_DIFF; Measurement_Point_Round-SMD-Pad_Big
C9, C12, C14, C15, C16, C17, C22, C23, C38, C42, C43, C44, C45: 0.1u; C_0805_HandSoldering; Digikey P/N 399-1168-1-ND
JP1: Jumper_NC_Dual; Pin_Header_Straight_1x03_Pitch2.54mm
Q2: MMBF170; SOT-23; Digikey P/N MMBF170CT-ND
R5, R21, R22, R23, R28, R29, R31, R39, R40, R41, R42, R50: 10k; R_0805_HandSoldering; DigiKey P/N P10.0KCCT-ND
R20, R35, R45, R46: 16k; R_0805_HandSoldering; DigiKey P/N P10.0KCCT-ND
R24, R30: 100k; R_0805_HandSoldering; DigiKey P/N P100KCCT-ND
R25, R26: 4k; R_0805_HandSoldering; DigiKey P/N P2.00KCCT-ND
R32, R34: 4k; R_0805_HandSoldering; DigiKey P/N P4.75KCCT-ND
R33, R79, R81, R82, R83: 499; R_0805_HandSoldering; DigiKey P/N P499DACT-ND
R38, R80: 9.31k; R_0805_HandSoldering; Digikey P/N P9.31KCCT-ND
R51: 250k; R_0805_HandSoldering; DigiKey P/N P249KCCT-ND
RV1, RV2, RV3, RV4: 2k; trim_pot
SW2: TS5A3159-Q1; SOT-23-6_Handsoldering; DigiKey P/N 296-39512-1-ND
Thrtl_LPF1: Throttle_LPF; Measurement_Point_Square-SMD-Pad_Big
Thrtl_LV1: Throttle_LV; Measurement_Point_Round-SMD-Pad_Big
Thrtl_PL1: Throttle_PL; Measurement_Point_Round-SMD-Pad_Big
Thrtl_uC1: Throttle_uC; Measurement_Point_Square-SMD-Pad_Big
U2: MCP6002; SOIC-8_3.9x4.9mm_Pitch1.27mm; DigiKey P/N MCP6002T-I/SNCT-ND
U3: MCP6004; SOIC-14_3.9x8.7mm_Pitch1.27mm; Digikey P/N MCP6004T-I/SLCT-ND
U5: LM7810CT; TO-220_Horizontal_Plated_Hole; DigiKey P/N LM7810CT-ND
U6, U18: TS912; SOIC-8_3.9x4.9mm_Pitch1.27mm; DigiKey P/N 497-10252-1-ND
U8: 74ACT11030; SOIC-14_3.9x8.7mm_Pitch1.27mm; Digikey P/N 296-4180-1-ND
U22: TS372; SOIC-8_3.9x4.9mm_Pitch1.27mm; DigiKey P/N 497-2271-1-ND
U23: TLP293; SOP-4_4.4x2.8mm_Pitch1.27mm; DigiKey P/N TLP293(GB-TPLECT-ND

Connections:
+5V: C42.1, C43.1, C44.1, C45.1, R23.1, R35.1, R40.2, R41.2, R79.2, R82.2, SW2.5 (V+), U2.8 (V+), U3.4 (V+), U8.1, U8.2, U8.11 (VCC); also elsewhere on the board
+24V: C12.1, C14.1, U5.1 (IN); also elsewhere on the board
/BP_uC: U23.4; also elsewhere on the board
/ThrottlePlausibility/APPS1_ISO: APPS1_ISO1.1, C15.1, R29.2, U3.2 (-), U3.5 (+), U18.1
/ThrottlePlausibility/APPS1_b: APPS1_b1.1, R22.1, R31.1, U6.1, U6.2 (-)
/ThrottlePlausibility/APPS2_b: APPS2_b1.1, R5.1, R39.1, U3.9 (-), U3.12 (+), U6.6 (-), U6.7
/ThrottlePlausibility/Pedal_Out: JP1.3, U2.1, U2.2 (-)
/Throttle_LV: SW2.4 (COM), Thrtl_LV1.1; also elsewhere on the board
/Throttle_PL: R21.2, Thrtl_PL1.1, U8.5; also elsewhere on the board
/Throttle_SEL: SW2.6 (IN); also elsewhere on the board
/Throttle_uC: R20.2, Thrtl_uC1.1; also elsewhere on the board
APPS1: R30.1; also elsewhere on the board
APPS1_10: +10V1.1, C17.1, C23.1, C38.1, R32.2, RV1.1, U5.3 (OUT), U6.8 (V+), U18.8 (V+), U22.8 (V+); also elsewhere on the board
APPS1_RTN: R26.2; also elsewhere on the board
APPS2: R24.1; also elsewhere on the board
APPS2_5: R25.1; also elsewhere on the board
BP: R51.1; also elsewhere on the board
CH_GND: C12.2, C14.2, C16.2, C17.2, C22.2, C23.2, C38.2, C42.2, C43.2, C44.2, C45.2, Q2.2 (S), R28.1, R42.2, R45.2, R81.1, R83.1, RV2.2, RV2.3, RV4.2, RV4.3, SW2.2 (GND), SW2.3 (NC), U2.4 (V-), U3.11 (V-), U5.0 (GND), U5.2 (GND), U6.4 (V-), U8.4 (GND), U18.4 (V-), U22.4 (V-), U23.2, U23.3; also elsewhere on the board
unnamed: APPS_DIFF1.1, R50.2, U18.7, U22.2 (-), U22.5 (+)
unnamed: C9.1, JP1.1, R46.1, Thrtl_LPF1.1, U2.7
unnamed: C9.2, R20.1, R46.2, U2.6 (-)
unnamed: C15.2, R23.2, R29.1, U18.2 (-)
unnamed: C16.1, R24.2, U6.5 (+)
unnamed: C22.1, R30.2, U6.3 (+)
unnamed: JP1.2, SW2.1 (NO)
unnamed: Q2.1 (G), R21.1
unnamed: Q2.3 (D), R5.2, U2.3 (+)
unnamed: R22.2, R28.2, U18.3 (+)
unnamed: R25.2, RV1.2, RV1.3
unnamed: R26.1, RV2.1
unnamed: R31.2, R42.1, U18.5 (+)
unnamed: R32.1, RV3.1
unnamed: R33.1, R34.2, U22.6 (-)
unnamed: R33.2, RV3.2, RV3.3, U22.3 (+)
unnamed: R34.1, RV4.1
unnamed: R35.2, R45.1, U2.5 (+)
unnamed: R38.1, R82.1, U3.10 (+)
unnamed: R38.2, R83.2, U3.13 (-)
unnamed: R39.2, R50.1, U18.6 (-)
unnamed: R40.1, U8.3, U22.1
unnamed: R41.1, U8.8, U22.7
unnamed: R51.2, U23.1
unnamed: R79.1, R80.1, U3.3 (+)
unnamed: R80.2, R81.2, U3.6 (-)
unnamed: U3.1, U8.9
unnamed: U3.7, U8.12
unnamed: U3.8, U8.13
unnamed: U3.14, U8.14

Notes on the sheet:
Used for 10V rail-to-rail ability
Used for rail-to-rail on 5V
Plausibility Window (0.5V)
Brake Pressed
Open/Short Window (90% travel)
APPS2 2k pot.
APPS1 2k pot.
Inv. signal Curr. Transfer. Ratio=100%
APPS 5V Offset Bias
Look at datasheet for footprint design specs
Consider using potentiometer for R33, or R34&R32 (Plausibility Window Compators). This way sensitivity may be altered depending on configuration. Note: Current value of 499 does NOT give 10% window (incorrect, gives 5%)
Current configuration means +24_RTN & CH_GND are tied on DC/DC. Consider using DC/DC w/ dual outputs to avoid giving up isolation, e.g. +24V to +5V AND +10V Additionally, expose the GND plane underneath the package of this regulator (footprint). Should allow for better heat dissipation.
If this arrangement is used, perhaps add clamping diodes to better protect from outside signals. With the clutter of the box, it is easy to connect wires incorrectly. R25 and R26 could be replaced by potentiometers, so that tuning to the pedal cluster can be more accurate. R25 and R26 are also inco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
APPS1 Stepdown
Brings the 5-10V biases APPS1 signal down to 0-5V
10V Regulator
Throttle Select Switch
RED
