phelanp/TSI-2018/Circuit_layout/Circuit_layout.kicad_pcb

## KiCad design Circuit_layout/Circuit_layout.kicad_pcb (continued)

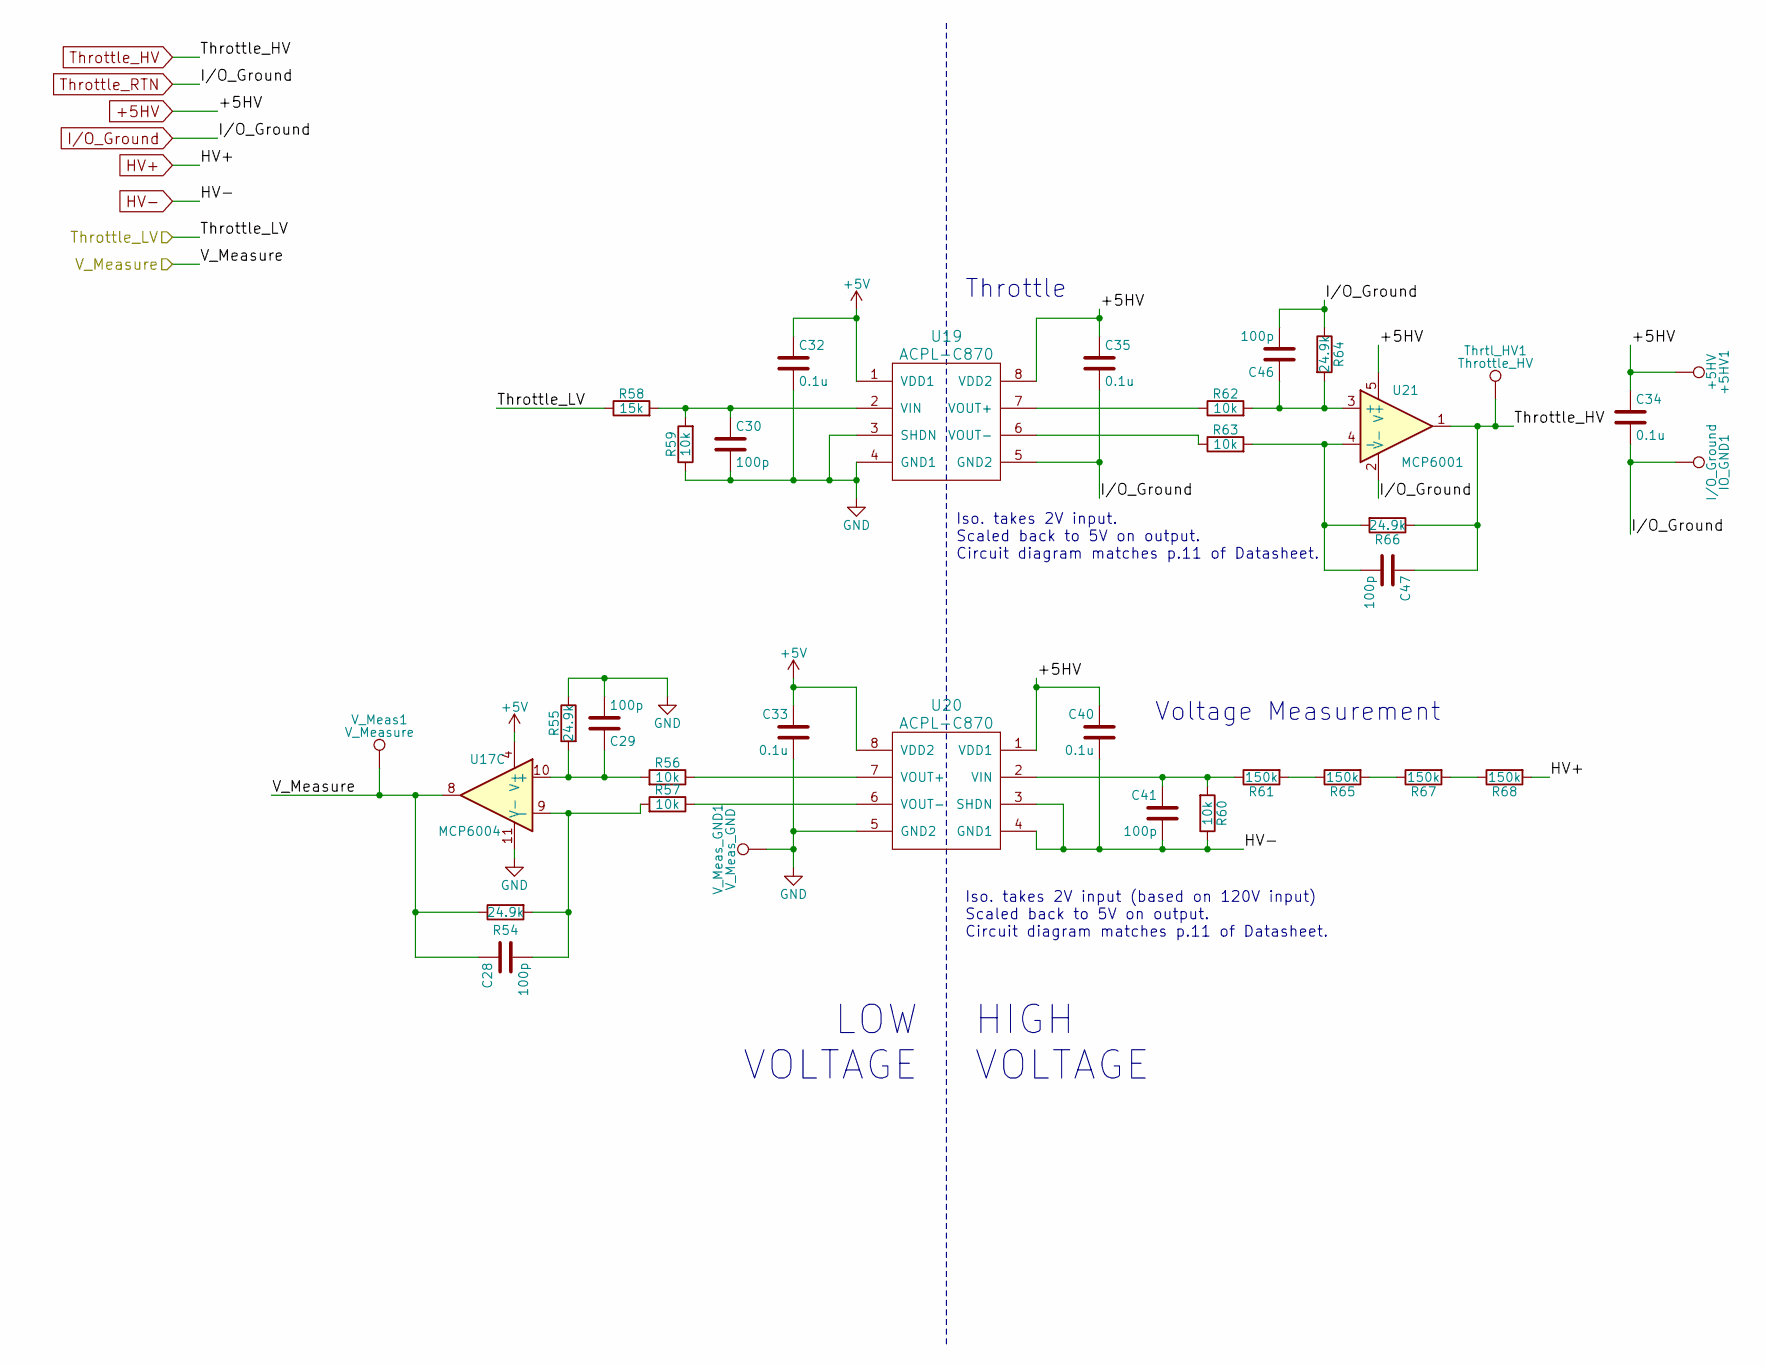
[picture p17: schematic isolators.sch, Tractive System Interface]

Parts:
+5HV1: +5HV; TSSOP-16-1EP_4.4x5mm_Pitch0.65mm
C28, C29, C30, C41, C46, C47: 100p; C_0805_HandSoldering; DigiKey P/N 399-1122-1-ND
C32, C33, C34, C35, C40: 0.1u; C_0805_HandSoldering; Digikey P/N 399-1168-1-ND
IO_GND1: I/O_Ground; Measurement_Point_Round-SMD-Pad_Big
R54, R55, R64, R66: 24.9k; R_0805_HandSoldering; DigiKey P/N P24.9KCCT-ND
R56, R57, R59, R60, R62, R63: 10k; R_0805_HandSoldering; DigiKey P/N P10.0KCCT-ND
R58: 15k; R_0805_HandSoldering; DigiKey P/N P24.9KCCT-ND
R61, R65, R67, R68: 150k; R_0805_HandSoldering; DigiKey P/N P150KCCT-ND
Thrtl_HV1: Throttle_HV; Measurement_Point_Round-SMD-Pad_Big
U17: MCP6004; SOIC-14_3.9x8.7mm_Pitch1.27mm; Digikey P/N MCP6004T-I/SLCT-ND
U19, U20: ACPL-C870; Iso_Diff_Amp_ACPL; Digikey P/N 516-2578-5-ND
U21: MCP6001; SOT-23-5_HandSoldering; DigiKey P/N MCP6001T-I/OTCT-ND
V_Meas1: V_Measure; Measurement_Point_Round-SMD-Pad_Big
V_Meas_GND1: V_Meas_GND; Measurement_Point_Square-SMD-Pad_Big

Connections:
+5HV: +5HV1.1, C34.1, C35.1, C40.1, U19.8 (VDD2), U20.1 (VDD1), U21.5 (V+); also elsewhere on the board
+5V: C32.1, C33.1, U17.4 (V+), U19.1 (VDD1), U20.8 (VDD2); also elsewhere on the board
/Throttle_LV: R58.1; also elsewhere on the board
/V_Measure: C28.1, R54.1, U17.8, V_Meas1.1; also elsewhere on the board
CH_GND: C29.2, C30.2, C32.2, C33.2, R55.1, R59.1, U17.11 (V-), U19.3 (SHDN), U19.4 (GND1), U20.5 (GND2), V_Meas_GND1.1; also elsewhere on the board
HV+: R68.2; also elsewhere on the board
HV-: C40.2, C41.2, R60.1, U20.3 (SHDN), U20.4 (GND1); also elsewhere on the board
I/O_Ground: C34.2, C35.2, C46.2, IO_GND1.1, R64.1, U19.5 (GND2), U21.2 (V-); also elsewhere on the board
unnamed: C28.2, R54.2, R57.2, U17.9 (-)
unnamed: C29.1, R55.2, R56.2, U17.10 (+)
unnamed: C30.1, R58.2, R59.2, U19.2 (VIN)
unnamed: C41.1, R60.2, R61.1, U20.2 (VIN)
unnamed: C46.1, R62.2, R64.2, U21.3 (+)
unnamed: C47.2, R63.2, R66.2, U21.4 (-)
unnamed: R56.1, U20.7 (VOUT+)
unnamed: R57.1, U20.6 (VOUT-)
unnamed: R61.2, R65.1
unnamed: R62.1, U19.7 (VOUT+)
unnamed: R63.1, U19.6 (VOUT-)
unnamed: R65.2, R67.1
unnamed: R67.2, R68.1
Throttle_HV: C47.1, R66.1, Thrtl_HV1.1, U21.1; also elsewhere on the board

Notes on the sheet:
Throttle
Voltage Measurement
HIGH VOLTAGE
LOW VOLTAGE
Iso. takes 2V input. Scaled back to 5V on output. Circuit diagram matches p.11 of Datasheet.
Iso. takes 2V input (based on 120V input) Scaled back to 5V on output. Circuit diagram matches p.11 of Datasheet.

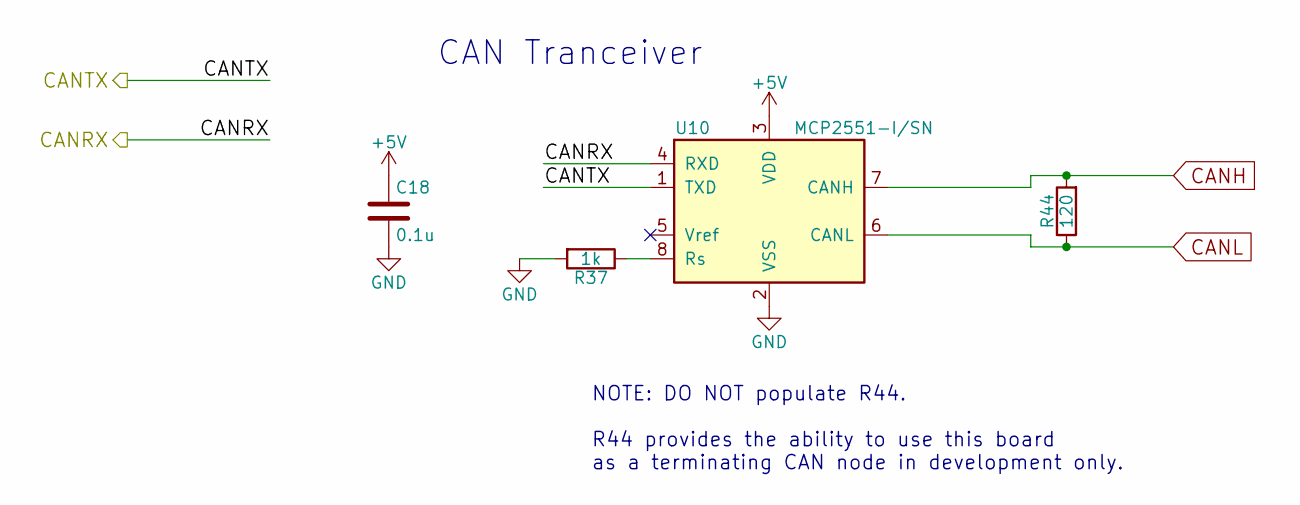
[picture p18: schematic Can_tcvr.sch, Tractive System Interface]

Parts:
C18: 0.1u; C_0805_HandSoldering; Digikey P/N 399-1168-1-ND
R37: 1k; R_0805_HandSoldering; DigiKey P/N P1.00KCCT-ND
R44: 120; R_0805_HandSoldering; DigiKey P/N 311-120CRCT-ND
U10: MCP2551-I/SN; SO-8; DigiKey P/N MCP2551-I/SN-ND

Connections:
+5V: C18.1, U10.3 (VDD); also elsewhere on the board
/CANRX: U10.4 (RXD); also elsewhere on the board
/CANTX: U10.1 (TXD); also elsewhere on the board
CANH: R44.2, U10.7 (CANH); also elsewhere on the board
CANL: R44.1, U10.6 (CANL); also elsewhere on the board
CH_GND: C18.2, R37.2, U10.2 (VSS); also elsewhere on the board
unnamed: R37.1, U10.8 (Rs)

Notes on the sheet:
CAN Tranceiver
NOTE: DO NOT populate R44. R44 provides the ability to use this board as a terminating CAN node in development only.

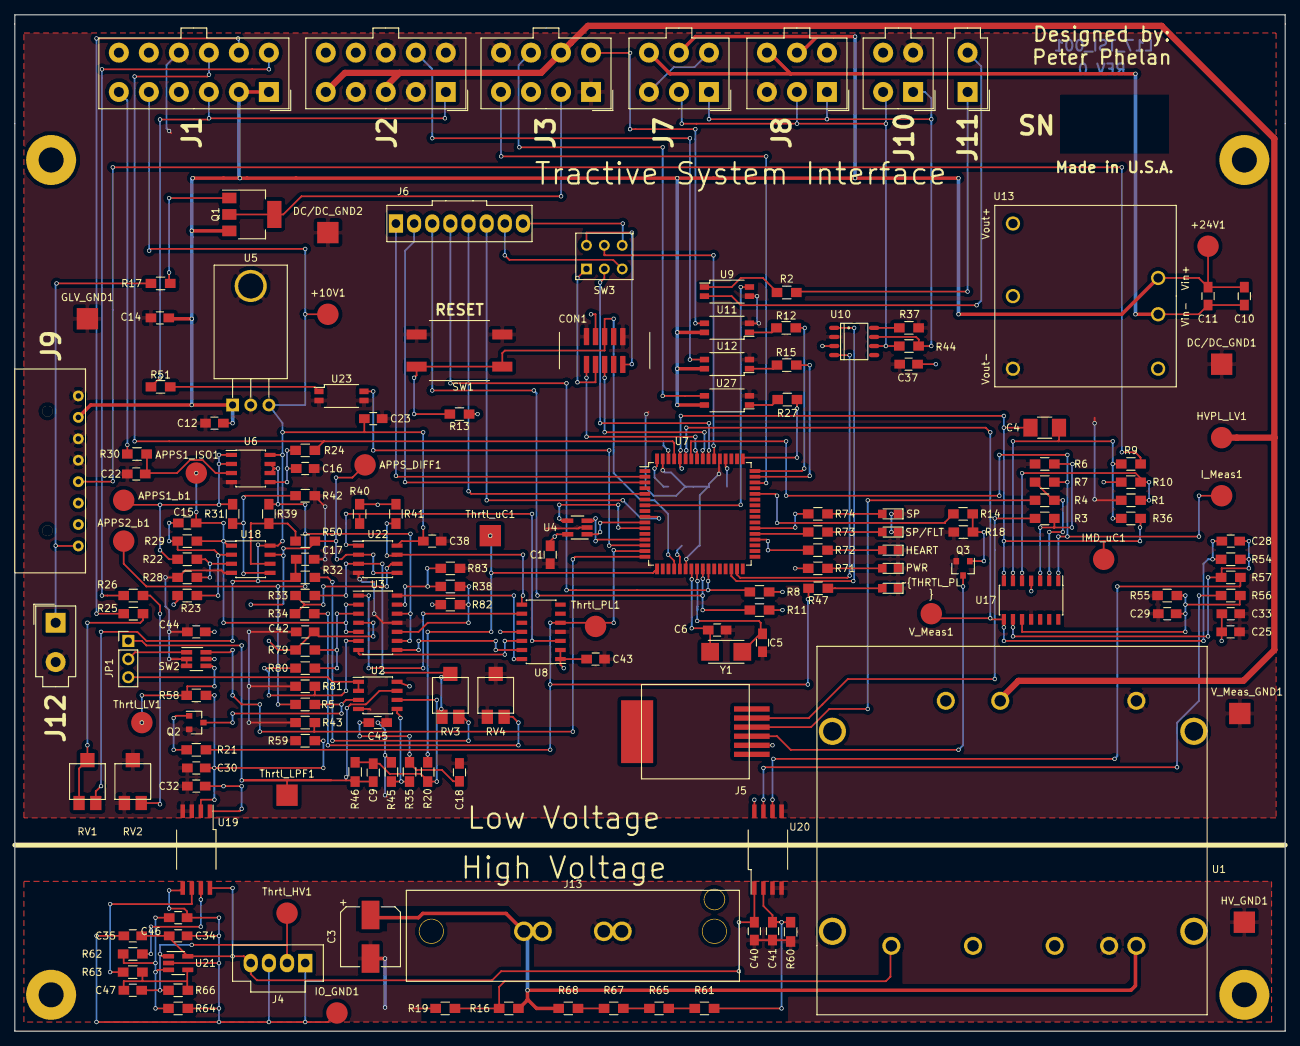
[picture p19: board Circuit_layout.kicad_pcb from above]

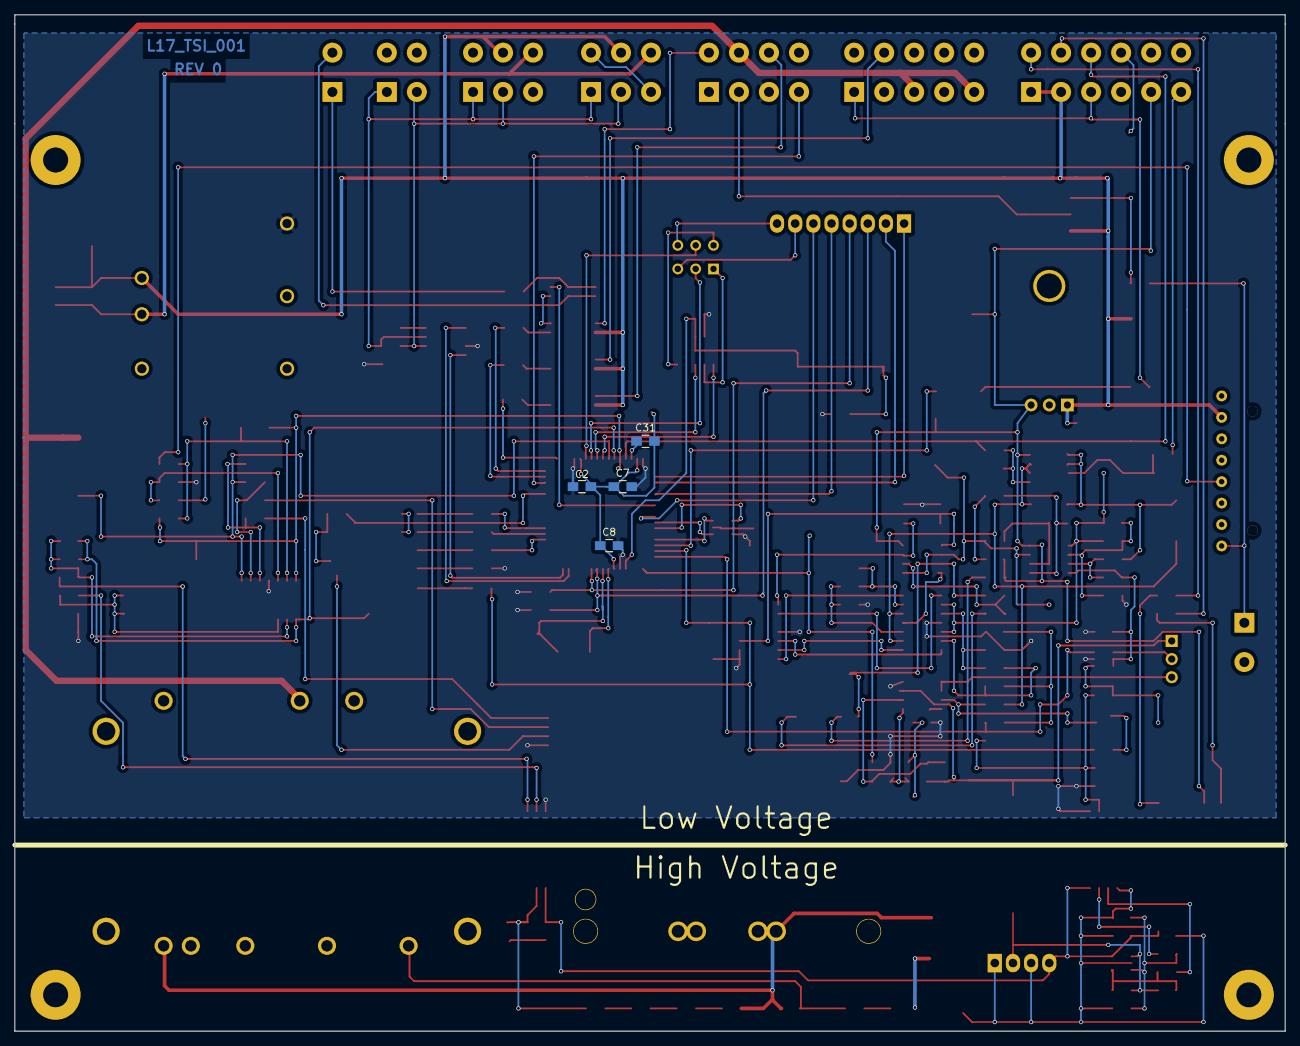
[picture p20: board Circuit_layout.kicad_pcb from below]

Board: 2 copper layers, 177.8 x 142.2 mm, 188 parts (4 on the bottom side), 133 nets.

Other parts of the board:
D5: ~Throttle_PL; LED_0805
R47: 1k; R_0805_HandSoldering

Their connections:
/Throttle_PL: R47.2; also elsewhere on the board
CH_GND: D5.1; also elsewhere on the board
unnamed: D5.2, R47.1
