phelanp/TSI-2018/interconnect_board_for_box/interconnect_board_for_box.kicad_pcb

## KiCad design interconnect_board_for_box/interconnect_board_for_box.kicad_pcb (2018-02-09)

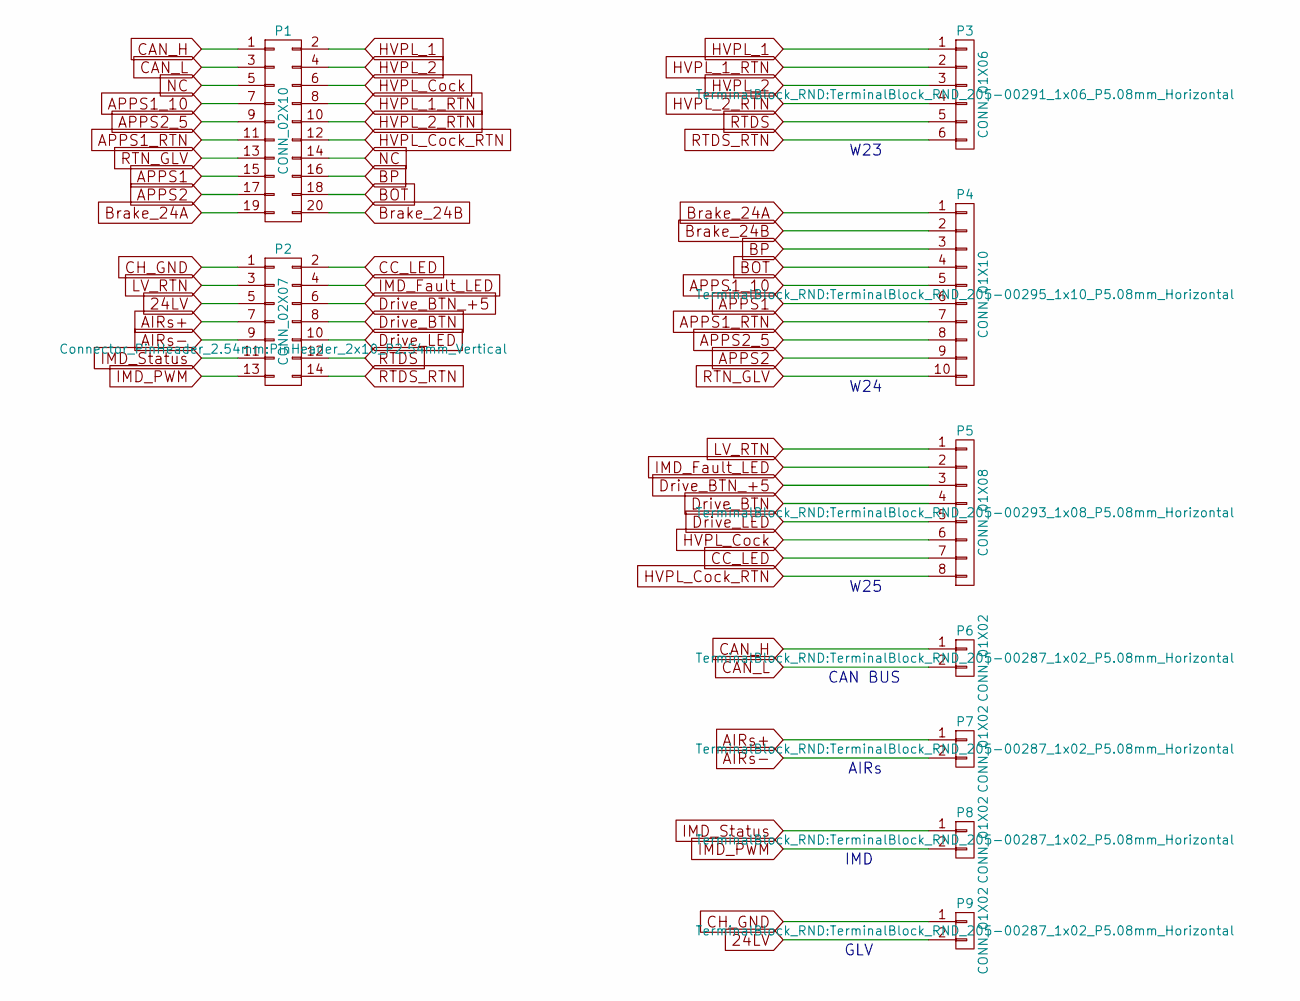
[picture p21: schematic interconnect_board_for_box.sch]

Parts:
P1: CONN_02X10; PinHeader_2x10_P2.54mm_Vertical
P2: CONN_02X07; PinHeader_2x07_P2.54mm_Vertical
P3: CONN_01X06; TerminalBlock_RND_205-00291_1x06_P5.08mm_Horizontal
P4: CONN_01X10; TerminalBlock_RND_205-00295_1x10_P5.08mm_Horizontal
P5: CONN_01X08; TerminalBlock_RND_205-00293_1x08_P5.08mm_Horizontal
P6, P7, P8, P9: CONN_01X02; TerminalBlock_RND_205-00287_1x02_P5.08mm_Horizontal

Connections:
24LV: P2.5, P9.2
AIRs+: P2.7, P7.1
AIRs-: P2.9, P7.2
APPS1: P1.15, P4.6
APPS1_10: P1.7, P4.5
APPS1_RTN: P1.11, P4.7
APPS2: P1.17, P4.9
APPS2_5: P1.9, P4.8
BOT: P1.18, P4.4
BP: P1.16, P4.3
Brake_24A: P1.19, P4.1
Brake_24B: P1.20, P4.2
CAN_H: P1.1, P6.1
CAN_L: P1.3, P6.2
CC_LED: P2.2, P5.7
CH_GND: P2.1, P9.1
Drive_BTN: P2.8, P5.4
Drive_BTN_+5: P2.6, P5.3
Drive_LED: P2.10, P5.5
HVPL_1: P1.2, P3.1
HVPL_1_RTN: P1.8, P3.2
HVPL_2: P1.4, P3.3
HVPL_2_RTN: P1.10, P3.4
HVPL_Cock: P1.6, P5.6
HVPL_Cock_RTN: P1.12, P5.8
IMD_Fault_LED: P2.4, P5.2
IMD_PWM: P2.13, P8.2
IMD_Status: P2.11, P8.1
LV_RTN: P2.3, P5.1
NC: P1.5, P1.14
RTDS: P2.12, P3.5
RTDS_RTN: P2.14, P3.6
RTN_GLV: P1.13, P4.10

Notes on the sheet:
W24
W23
W25
CAN BUS
AIRs
IMD
GLV

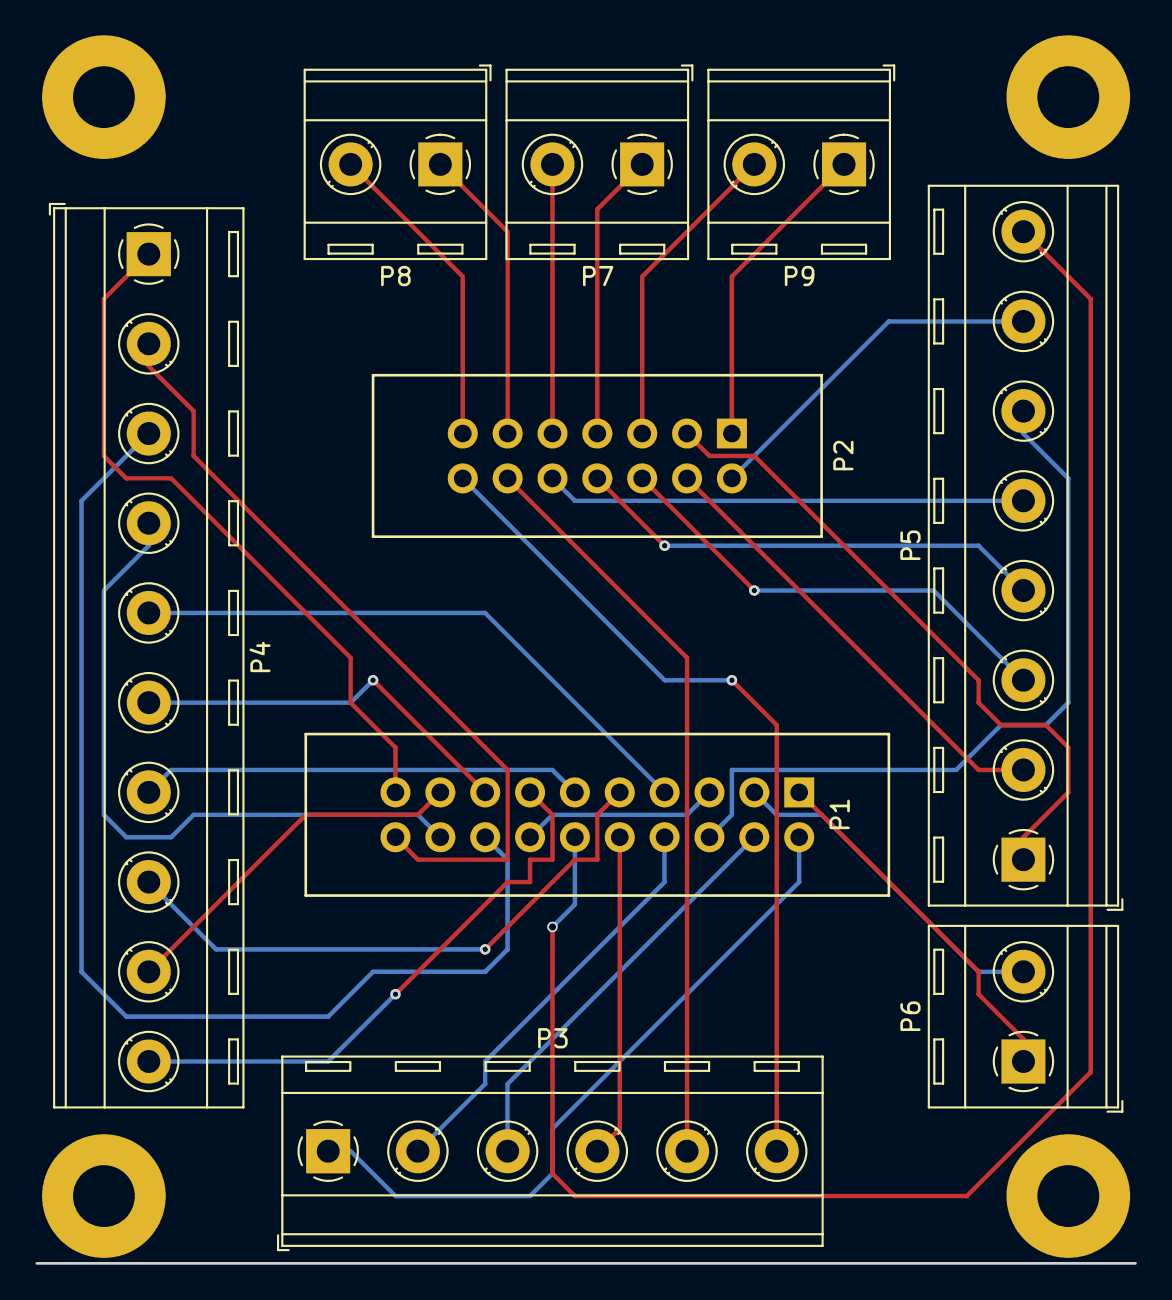
[picture p22: board interconnect_board_for_box.kicad_pcb from above]

Board: 2 copper layers, 9 parts (0 on the bottom side), 33 nets.
