phelanp/TSI-2018/interconnect_board/interconnect_board.kicad_pcb

## KiCad design interconnect_board/interconnect_board.kicad_pcb (2018-02-08)

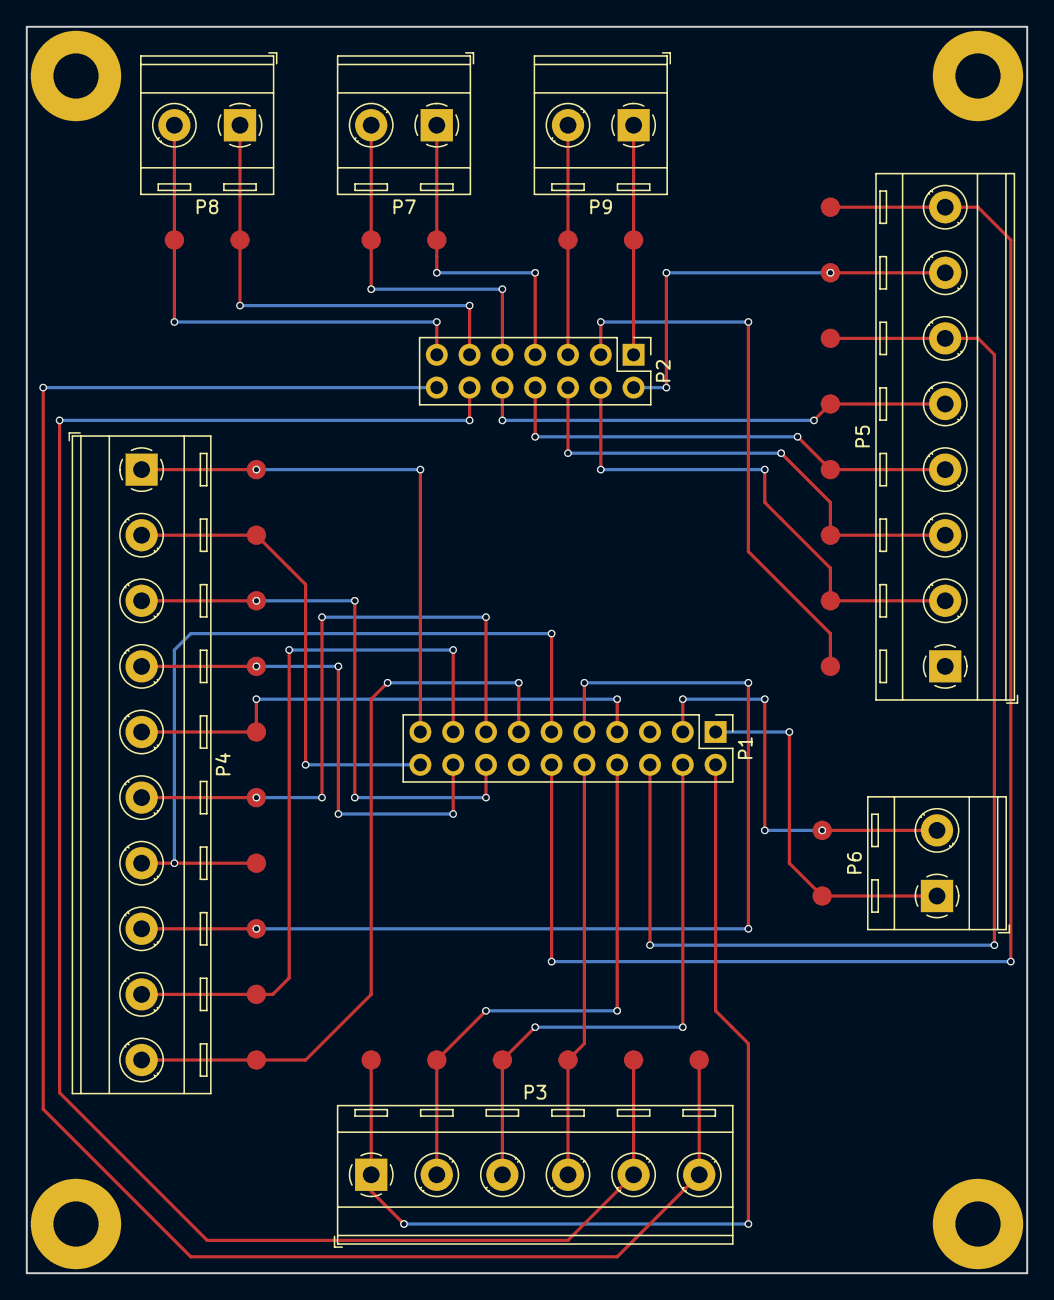
[picture p23: board interconnect_board.kicad_pcb from above]

Board: 2 copper layers, 77.5 x 96.5 mm, 41 parts (0 on the bottom side), 33 nets.

Parts:
P1: CONN_02X10; PinHeader_2x10_P2.54mm_Vertical
P2: CONN_02X07; PinHeader_2x07_P2.54mm_Vertical
P3: CONN_01X06; TerminalBlock_RND_205-00291_1x06_P5.08mm_Horizontal
P4: CONN_01X10; TerminalBlock_RND_205-00295_1x10_P5.08mm_Horizontal
P5: CONN_01X08; TerminalBlock_RND_205-00293_1x08_P5.08mm_Horizontal
P6, P7, P8, P9: CONN_01X02; TerminalBlock_RND_205-00287_1x02_P5.08mm_Horizontal
W1: HVPL_1; Measurement_Point_Round-SMD-Pad_Small
W2, W17: HVPL_1_RTN; Measurement_Point_Round-SMD-Pad_Small
W3: RTDS; Measurement_Point_Round-SMD-Pad_Small
W4: Brake_24A; Measurement_Point_Round-SMD-Pad_Small
W5: BP; Measurement_Point_Round-SMD-Pad_Small
W6: APPS1_10; Measurement_Point_Round-SMD-Pad_Small
W7: APPS1_RTN; Measurement_Point_Round-SMD-Pad_Small
W8: APPS2; Measurement_Point_Round-SMD-Pad_Small
W9: LV_RTN; Measurement_Point_Round-SMD-Pad_Small
W10: Drive_BTN_+5; Measurement_Point_Round-SMD-Pad_Small
W11: Drive_LED; Measurement_Point_Round-SMD-Pad_Small
W12: CC_LED; Measurement_Point_Round-SMD-Pad_Small
W13: CAN_H; Measurement_Point_Round-SMD-Pad_Small
W14: AIRs+; Measurement_Point_Round-SMD-Pad_Small
W15: IMD_Status; Measurement_Point_Round-SMD-Pad_Small
W16: CH_GND; Measurement_Point_Round-SMD-Pad_Small
W18: HVPL_2_RTN; Measurement_Point_Round-SMD-Pad_Small
W19: RTDS_RTN; Measurement_Point_Round-SMD-Pad_Small
W20: Brake_24B; Measurement_Point_Round-SMD-Pad_Small
W21: BOT; Measurement_Point_Round-SMD-Pad_Small
W22: APPS1; Measurement_Point_Round-SMD-Pad_Small
W23: APPS2_5; Measurement_Point_Round-SMD-Pad_Small
W24: RTN_GLV; Measurement_Point_Round-SMD-Pad_Small
W25: IMD_Fault_LED; Measurement_Point_Round-SMD-Pad_Small
W26: Drive_BTN; Measurement_Point_Round-SMD-Pad_Small
W27: HVPL_Cock; Measurement_Point_Round-SMD-Pad_Small
W28: HVPL_Cock_RTN; Measurement_Point_Round-SMD-Pad_Small
W29: CAN_L; Measurement_Point_Round-SMD-Pad_Small
W30: AIRs-; Measurement_Point_Round-SMD-Pad_Small
W31: IMD_PWM; Measurement_Point_Round-SMD-Pad_Small
W32: 24LV; Measurement_Point_Round-SMD-Pad_Small

Connections:
24LV: P2.5, P9.2, W32.1
AIRs+: P2.7, P7.1, W14.1
AIRs-: P2.9, P7.2, W30.1
APPS1: P1.15, P4.6, W22.1
APPS1_10: P1.7, P4.5, W6.1
APPS1_RTN: P1.11, P4.7, W7.1
APPS2: P1.17, P4.9, W8.1
APPS2_5: P1.9, P4.8, W23.1
BOT: P1.18, P4.4, W21.1
BP: P1.16, P4.3, W5.1
Brake_24A: P1.19, P4.1, W4.1
Brake_24B: P1.20, P4.2, W20.1
CAN_H: P1.1, P6.1, W13.1
CAN_L: P1.3, P6.2, W29.1
CC_LED: P2.2, P5.7, W12.1
CH_GND: P2.1, P9.1, W16.1
Drive_BTN: P2.8, P5.4, W26.1
Drive_BTN_+5: P2.6, P5.3, W10.1
Drive_LED: P2.10, P5.5, W11.1
HVPL_1: P1.2, P3.1, W1.1
HVPL_1_RTN: P1.8, P3.2, W17.1
HVPL_2: P1.4, P3.3, W2.1
HVPL_2_RTN: P1.10, P3.4, W18.1
HVPL_Cock: P1.6, P5.6, W27.1
HVPL_Cock_RTN: P1.12, P5.8, W28.1
IMD_Fault_LED: P2.4, P5.2, W25.1
IMD_PWM: P2.13, P8.2, W31.1
IMD_Status: P2.11, P8.1, W15.1
LV_RTN: P2.3, P5.1, W9.1
NC: P1.5, P1.14
RTDS: P2.12, P3.5, W3.1
RTDS_RTN: P2.14, P3.6, W19.1
RTN_GLV: P1.13, P4.10, W24.1
