phelanp/TSI-2018/(commit log)

2018-02-08 Added interconnect board
    [backup.kicad_pcb, interconnect_board.kicad_pcb, interconnect_board.sch]
2018-02-08 Placed component labels on interconnect board
    [interconnect_board.kicad_pcb]
2018-02-08 Added old TSI layout
    [Can_tcvr.sch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]
2018-02-09 Created smaller version of interconnect board for inside TSI box
    [backup.kicad_pcb, backup1.kicad_pcb, interconnect_board_for_box.kicad_pcb, interconnect_board_for_box.sch]
2018-02-09 Completed errata changes
    Committing before annotation, footprint assignment, and board relayout for backup purposes
    [Can_tcvr.sch, Circuit_layout.sch, Ext_Connectors.sch, PowerSystem.sch, StatusLights.sch, ThrottlePlausibility.sch, isolators.sch]
2018-02-09 Associated footprints and generated new netlist
    [Can_tcvr.sch, Circuit_layout.sch, StatusLights.sch, ThrottlePlausibility.sch, isolators.sch]
2018-02-09 Backup before pcb relayout
    [PowerSystem.sch, isolators.sch]
2018-02-09 Pots connected, just need to fit regulator on
    [Can_tcvr.sch, Circuit_layout.kicad_pcb, StatusLights.sch, ThrottlePlausibility.sch, isolators.sch]
2018-02-09 Board 1.1 for review
    [Circuit_layout.kicad_pcb]
2018-02-09 Updated R32 and R34
    [ThrottlePlausibility.sch]
2018-02-13 Wider traces for DC/DC converter
    [Can_tcvr.sch, Circuit_layout.kicad_pcb, Circuit_layout.sch, PowerSystem.sch, StatusLights.sch, ThrottlePlausibility.sch, isolators.sch]
2018-02-16 Finished internal wiring diagram
2018-02-16 updated wiring diagram
2018-02-16 created pdf of wiring diagram
2018-02-20 created new wiring diagram with proposed box changes, updated connectors on board
    [Circuit_layout.kicad_pcb, _saved_Ext_Connectors.sch]
2018-02-27 Generated gerber and drill files for board ordering
    [Can_tcvr.sch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]
2018-04-09 Schematic update
    Changed schematic to reflect board as assembeled
    [Can_tcvr.sch, Circuit_layout.sch, Ext_Connectors.sch, PowerSystem.sch, StatusLights.sch, ThrottlePlausibility.sch, _saved_Circuit_layout.sch, _saved_StatusLights.sch]
2018-04-10 Zipped current version
